Hans-Wis/Magpie_M3V/dv/cdc_rdc/README.md

# dv/cdc_rdc — M3V CDC/RDC/X-prop (ADR-0063 V2, pending)

Single-clock design -> RDC focus (domain_rstn, ADR-0047). See dv/README.md.
