Hans-Wis/Magpie_M3V/design/cpu_m1/rtl/README.md

# cpu_m1 RTL

RTL grows from canonical flow stage 2 (`fetch`). Legal internal and open-source
references may inform implementation, but provenance/license notes and
Magpie_M1-specific verification evidence are required when they shape design.
