Hans-Wis/Magpie_M3V/flow/v2_pipeline/phase_p_lint_current/cpu_m1_phase_p_lint_current/consolidated_reports/cpu_m1_top_lint_lint_rtl/README

################################################################################
#
# This file has been generated by SpyGlass:
#     Consolidated Reports Created by: edauser
#     Consolidated Reports Created on: Tue Jun  9 21:41:33 2026
#     Working Directory              : /home/edauser/project/SOC/Magpie_M1/flow/v2_pipeline/phase_p_lint_current
#     Consolidated Reports Location  : ./cpu_m1_phase_p_lint_current/consolidated_reports/cpu_m1_top_lint_lint_rtl/
#     SpyGlass Version               : SpyGlass_vX-2025.06-SP1
#
################################################################################

This directory contains critical reports generated in current run
In case this directory needs to be compressed using gtar, you may use - 

    % gtar -cvzf <compressed_tar_file_name> ./cpu_m1_phase_p_lint_current/consolidated_reports/cpu_m1_top_lint_lint_rtl/
