Hans-Wis/Magpie_M3V/docs/reports/gemma_opt_ledger.md

# Gemma-3 270M → M3V:架構優化實驗台帳(benchmark-driven)

> **用途**:固定 benchmark = §baseline;每個改善實驗記一列,對比 **vs baseline** + **vs 前一次**,
> 逐次逼近架構最佳執行方式。**鐵律**:每個實驗的 keep/revert 由「**bit-exact 綠 + profiler cycle delta**」
> 兩軌共同裁定——縮 scope / 破 bit-exact / 只在 TB 關功能一律 revert。
> **量測 harness**:`python sim/tools/profile_gemma_layer.py`(Verilator,建 npu_top+cpu_m1,跑 22-step 鏈)。
> **正確性 harness**:`sim/gates/gate_gemma3_layer_rtl.py` + S0–S5 分步 gate(bit-exact vs Tier-C golden)。
> **完整基準分析**:`docs/reports/2026-07-07_gemma270m_m3v_perf_baseline.md`(SSOT)。

---

## Baseline(固定 benchmark)

| 項目 | 值 |
|---|---|
| **一層 wall-clock** | **349,824 cyc**（HEAD @108f2af，profiler 重現 ±0，**已鎖定**）|
| 初始（Cycle-1 前）| 375,672 cyc |
| scalar core | ~89% wall（GEMM 33.3% / nonlinear 66.7%）|
| mat busy | 5,658（MAC 1,104 / requant 4,290）|
| dma busy | 34,955（10.0%）|
| representative dims | seq 4 · hidden 64 · nh 4 · hd 16 · ffn 128 |

**逐-step core\*（重現確認,前 5 大熱點）**:ewise_mul **36,547** · QK-norm_q 29,857 · RoPE_q 25,835 ·
RMSNorm(×4 各 ~23.8-24.1k) · gate/up_proj 各 18,002。**單步之冠 = ewise_mul 36,966 total。**

---

## 實驗紀錄

| # | 實驗 | 改動層 | 攻擊 | vs baseline | vs prev | bit-exact | 判定 |
|---|---|---|---|---:|---:|---|---|
| **E0** | baseline（RVV Cycle-1 residual）| RVV firmware | residual | — | — | ✅ gate 綠 | **BENCHMARK** |
| **E1** | **ADR-0066 MAT_REQUANT_VEC — ewise_mul requant 卸給 mat_engine 64-bit** | RTL(+S_LV)+ SSOT + firmware + runtime | ewise_mul 36,966（單步之冠）| *(E1a RTL done, E1b runtime pending)* | — | E1a ✅ | 🔄 E1a 完成 |
| **PA** | **ADR-0067 v2 Phase A — GEMM 硬體 tile sequencer**（npu_ml_ctrl）| 新 RTL(control shell)+ mux + firmware + gate_67 | GEMM per-tile 編排稅 | **q_proj 13,350→4,282 = 3.12×** | — | ✅ 512/512 byte-exact | ✅ **達標(超 ≥2×)** |
| **B1** | **Phase B B1 — activation-stationary**（activation 載一次@TCM 0xB40)| npu_ml_ctrl S_LOADA + mode bit + runtime blob 重打包 | DMA 冗餘 activation 重載 | **4,282→3,403 = vs 韌體 3.92×** | **−879(dma −893)** | ✅ 512/512 | ✅ **達標** |

**PA 實測分解(gate_67,q_proj 8-tile,我獨立跑)**:ML 硬體路 4,282 = mat **680**(=韌體 680,計算不變)+ dma **3,408**(≈韌體 3,618)+ **編排 194**(韌體 core* 9,052→194,**46× 縮**)。**省的 100% 是 per-tile 韌體編排稅**;mat=680 相同證同一 GEMM(apples-to-apples)。**新瓶頸=DMA(80%)→ Phase B(overlap + activation-stationary)。** RTL review-clean(Grok 無 FSM bug + Codex 3 must-fix 已修:registered readback / !cfg_bypass / err 終止)· ML_V2_EN=0 零回歸(gate_45/46)。commits d360a03/6df51ed/3958919。

**B1 實測(gate_67 B1 test,我獨立跑,@415ac80)**:q_proj 4,282→**3,403**,dma 3,408→**2,515(−893=冗餘 activation,精準命中投影)**,mat 680 不變,other 194→208(多一次 S_LOADA)。**bit-exact 512/512(同 golden)**。設計+Grok/Codex review 一致(B1-first / TCM_ACT=0xB40 / group-scoped / bit-exact 驗證取代 E1 交易等價 / B2 延後)。gate_67 加 dma<3000 守衛防「照載不誤」。scope=n_groups==1(case assert)。Phase A 路仍 4,282 可選;零回歸。**效能軌跡:韌體 13,350 → PA 4,282(3.12×)→ B1 3,403(3.92×)。下一步 B1.1 header-trim(Grok ~2,400=~5.5×,Codex 提醒較大 layout surgery)/ B1.2 multi-group / B2 double-buffer(延)。**

---

## 實驗細節

### E0 — Baseline
- **內容**:HEAD 現況。RVV Cycle-1 已把 residual 19,251×2 → 6,306(3.05×),layer 375,672 → 349,824。
- **證據**:profiler 重現 **349,824(±0)**;S0–S5 gate 全綠。
- **狀態**:固定 benchmark。後續所有實驗對此列比。

### E1 — ADR-0066 MAT_REQUANT_VEC（ewise_mul requant 卸載）
- **假設**:ewise_mul(36,966,全層單步之冠)的 core* 是純量逐元素 srdhm(`__ashrdi3` per-element
  function call)。改成 RVV 算 int32 `a·b` 前段 + mat_engine 現成 64-bit srdhm 後段(新 CMD_LOADVEC +
  CQ opcode 14),預期單步 36,966 → **~10-15k(保守 2-4×)~ 2.5-4k(樂觀)**。
- **為何是 bit-exact by construction**:走的就是 CMD_RESCALE datapath,ewise golden 本來就 mat_engine 同源。
- **改動**:①SSOT yaml(opcode 14 + CMD_LOADVEC)→ regen 3 artifact(gate_35 regen-diff)②mat_engine.v
  加 S_LV(照 review §2 修正:param_bad + t_a_re + padded-64 契約)③firmware handler ④runtime lowering。
- **驗證**:單元 bit-exact(64 相異 int32 vs mat_golden.requant,防退化廣播/transpose)→ gate_gemma3_s0
  byte-identical → profiler 量 ewise_mul 單步 + layer delta。
- **步序(a/b 拆分,增量 de-risk)**:
  - **E1a ✅ 完成且全綠(2026-07-07,Codex 實作 + Claude 獨立驗證)**:SSOT(opcode 14 + CMD_LOADVEC=3'd5)
    + mat_engine.v `S_LV=4'd9`(el_grp 8-window 線性載 acc[0..63]、t_a_re 含 S_LV、param_bad clause、
    review §2 修正全含)+ firmware `CQ_OP_MAT_REQUANT_VEC` handler(含 out_base 還原)+ 單元 TB。
    **驗證(Claude 獨立跑)**:①單元 bit-exact `checks=134`(64 相異 int32 含 I32_MIN/MAX/負 corner,
    逐 byte vs mat_golden.rescale,distinct+>48-varied 斷言防廣播/transpose,param_bad 兩項)②gate_35
    regen-diff 4 passed ③lint 0 新 warning ④**additive-safety 回歸 gate_45/46 = 3 passed(舊 GEMM/RESCALE
    bit-exact 不變,確認純 additive)**。RTL diff 人工複審正確(S_LV 無 transpose/off-by-one)。
    **硬體 requant-offload 路 bit-exact 已證。**
  - **E1b(待 E1a 綠)**:runtime ewise_mul lowering = RVV int32 `a·b` 前段 + MAT_REQUANT_VEC 描述子;
    gate_gemma3_s0 byte-identical → profiler 量 ewise_mul 單步 + layer delta → 填 E1 列(vs baseline/prev)。
- **descriptor packing(定案,比 ADR 草稿精簡:per-tensor 免 TCM param blob)**:W0=op14+ACC(bank)+RPT;
  W1=mult_q31;W2=(rsp<<16)|clamp[rsp=(out_zp<<8)|shift,clamp=(clamp_max<<8)|clamp_min];W3=(src<<16)|dst。
  handler 設 out_base=dst 後還原 0x800(防 state 污染 GEMM RESCALE)。

---

## 決策日誌(為何選這個實驗)

- **2026-07-07 · E0 鎖定 + E1 選定**:baseline profiler 重現 **349,824 ±0**。原 roadmap #1 = GEMM
  de-spin,但 **root-cause 重排了它**:
  - `_chunks` 已最佳(K=64→1 chunk);gate_proj = 16 tiles × 6 CQ-op = 96 op,**core* 18,002 = 每-op
    韌體固定稅 ~187 cyc**(descriptor fetch + csr_write noinline + loop),與引擎/DMA 不重疊。
  - **單純融合 q/k/v 只省 step 級固定稅(~2%)**——op 數是 per-tile,融合不減 op。真正砍 GEMM core* =
    砍每-op 韌體成本 = **高 blast radius 共享韌體**(影響全部 tflm/mobilenet/mlperf/gemma gate)。
  - **結論:GEMM 是「小 ROI + 高風險」,不宜當 E1。** 逐-step 看,**ewise_mul 單步 36,966 = 全層最大單體**,
    ADR-0066 已三方 review=ACCEPT、bit-exact by construction、攻最大熱點 → **ROI/風險雙勝,選為 E1**。
    (GEMM 每-op 韌體瘦身 + activation-stationary 留作後續實驗,待 E1 建立迴圈信心後再碰共享韌體。)

- **2026-07-08 · soc M3a = npu_dma AXI 寬度隨 LANES(DMA 瓶頸 bus-層攻)**:v2 Phase B 後 q_proj 殘餘 ~80%
  = DMA。`DMA_DATA_W∈{32,64,128,256}` hard-bind 64×MAT_LANES,拓寬權重載入路(寬 AXI 讀 + 寬 SRAM 讀 +
  WPB bank-parallel TCM 寫),writeback 保持窄。**ml_v2 q_proj B1.1 全 SKU bit-exact 實測**:

  | SKU | DMA_DATA_W | total cyc | mat | **dma** | other |
  |---|---|---|---|---|---|
  | LANES=4 | 32(regression) | 2425 | 680 | **1539** | 206 |
  | LANES=1 | 64 | 2137 | 1064 | **867** | 206 |
  | LANES=2 | 128 | 1546 | 808 | **531** | 207 |
  | LANES=4 | 256 | 1243 | 680 | **363** | 200 |

  **dma 1539→363(/4.2)** 單調降(純載入 beats /WPB;殘餘=窄 writeback 16 字 + AR floor→M3b 再推)。
  **balanced-design 兌現**:LANES1/64b(2137)快過 LANES4/32b(2425)=DMA 是瓶頸,寬 bus 即使少 MAC 仍勝;
  LANES4/256b(1243)=MAC+bus 齊寬最快。q_proj 軌:韌體 13,350→PA 4,282→B1.1 2,425→**M3a/256b 1,243(10.7×)**。
  零回歸 default-32 位元同。green-wash:SRAM 真一拍供 WPB 字(dma 單調降即證)。ADR-0068 §2.5/M3;
  SSOT `design/npu/docs/npu_dma_m3_width_design.md`。**下一步 M3b writeback 寬化 + CQ 對齊泛化。**

- **2026-07-08 · soc M3b-1 = DMA writeback 寬化(dma floor 再降)**:M3a 讀路寬化的鏡像上寫路(npu_dma STORE
  發寬 AW/W beat + 寫側 ERR_ALIGN + npu_tcm DMA 讀埠 WPB parallel)。ml_v2 q_proj B1.1 @256b:**dma 363→251
  (-112cyc)**、total 1,243→**1,129**;per-tile STORE 16 字×8=128 窄 beats→16 寬 beats,如預測。全 bit-exact
  + 零回歸 12 passed。**q_proj 軌:韌體 13,350→PA 4,282→B1.1 2,425→M3a 1,243→M3b-1 1,129(11.8×)**。
  剩 M3b-2(CQ prefetch 對齊)+ M3b-3(region guard)。SSOT `design/npu/docs/npu_dma_m3b_design.md`。

- **2026-07-08 · soc M3b-2 = narrow two-tier DMA(通用 CQ 路寬 SKU 安全,非 perf)**:寬 DMA SKU 下通用
  cq_sequencer 路(gate_46/gemma)會 ERR_ALIGN-trap(descriptor prefetch ring 幾何無法對齊)。Option C:
  npu_ml_ctrl 快路維持寬(dma=251 不變)+ CSR/通用路 hard-tie 窄(不 trap,cq_sequencer 零改)。gate_46
  @256 bit-exact 零 trap。兩層共存一 npu_dma。誠實 two-tier(不宣稱 full 256b everywhere)。

- **2026-07-08 · soc M3c = npu_dma 寬度 PPA(DC TSMC28,寬 DMA 相對計算近乎免費)**:真 Synopsys DC 綜合
  npu_dma(std-cell)掃 DMA_DATA_W 32/64/128/256 @1.2ns:面積 689→809→919→1143µm²(+66%,8×寬只
  1.66×面積 sub-linear,增長全 combinational 資料路,flops 持平)。npu_dma@256=1143µm² vs mat_engine
  256-MAC=83,868µm² → 寬 DMA 資料路 ~1.4% 引擎面積 → **付 +453µm² 換 dma cycle ~6×(1539→251)= 明確
  PPA win**;balanced-design SKU 成立。caveat:SRAM/TCM macro 埠寬另計。報告 2026-07-08_dma_width_ppa.md。
  **soc M3 全弧完成(M1→M2→M3a→M3b→M3c)= 兩-AXI 架構 + PPA 驗證;q_proj 13,350→1,129(11.8×)。**

- **2026-07-08 · RMSNorm→RVV(最大單筆非線性軟體省,零 RTL)**:向量化 scalar MAT_RMSNORM 每元素 64-bit
  SRDHM scale loop → in-core Zve32x(sum_sq=vwmul+vredsum 精確;scale=vwmul→vsmul.vx(M)→vssra.vx(S)→
  vmax/vmin→vncvt→i8,vxrm=rnu csrw)。**rounding 重定義(Gemma-private)+ 獨立 Spike-validated golden**
  (rvv_bitmodel.py 純 spec;gate_rvv_bitmodel_spike vs Spike → 非湊 RTL)。**cycle RMSNorm ~24k→~13k/op
  (-11k×4≈-44k/層);全層 349,824→307,458**。**flip 0/256 max delta 0**(RVV rounding 對 real tensor 輸出
  完全相同=重定義實質 no-op)。gate_gemma3_s1(hidden=64)+ layer 全鏈 bit-exact(我獨立 5 passed);disasm
  無 __muldi3/__divdi3/__ashrdi3。誠實:hidden=64 驗;H=640 全模型 descriptor 加寬 follow-up。
