Hans-Wis/Magpie_M3V/design/npu/docs/strip_rail_promotion_design.md

# Strip 模式推廣到真 rail(設計確認,§2;ADR-0073 addendum)

Status: ACCEPTED-to-implement(User 裁示 2026-07-10「strip 模式推廣到 gemma/tflm
真 rail」;契約承 ADR-0073,本檔僅收斂推廣面)
原則:**同輸出、換運輸** —— 全部既有 golden(gate_46/gemma/tflm)一個位元組都
不改;GEMM 步的執行從「逐-tile 通用 CQ op 鏈」換成「單一 strip job」。

## 1. CQ SSOT 新 op(gate_35 regen-diff 守衛)

`MAT_STRIP_GEMM`(value **15**):
- `W1` = W_BASE(shared/DDR byte 位址,4KB 對齊 —— sanitizer 檢)
- `W2` = `(N_STRIPS[11:0]<<17) | STRIP_BYTES[16:0]`
- `W3` = `(K_CHUNKS[7:0]<<24) | (K_TAIL[6:0]<<17) | (N_TAIL[6:0]<<10) | out_dst64[9:0]`
  (out 目的 = shared byte 位址 / 64;block 本就 64B 對齊)
- 語意:sequencer 驗參(沿 ADR-0073 illegal 表 + 4KB 對齊 + out 界內)→ 寫
  ml_ctrl CSR(0x94..0xA8 + 新 **ML_OUT_BASE 0xAC**)→ GO → poll ML_STATUS.DONE;
  ml 錯(含 ML_STRIP_DMA_ERR=9)→ `cq_halt(CQ_ERR_MAT_PARAM 家族新碼 STRIP_ERR)`。
- **shared strip job blob 契約(凍結,2026-07-10 addendum)**:`W_BASE` 起連續:
  `[weights: N_STRIPS*STRIP_BYTES] ++ [param blocks: ceil((N_STRIPS*64)/8)*64B]
  ++ [activation chunks: K_CHUNKS*512B]`。activation chunk 維持每 chunk `[k][8]`
  packing(8 rows × 64 k,尾段由 emitter 補零)。`N_TAIL` 只裁最後 strip 的 compute;
  params 的 N 由 `N_STRIPS*64` 推得,tail param blocks 仍存在且由 emitter zero-pad。
- **sequencer staging 契約**:`MAT_STRIP_GEMM` handler 自行用 wrap-safe bounds 驗
  shared blob/TCM 目的範圍,再把 params copy 到 `0x1200+i*64`,activation chunks copy 到
  `OP_A_ADDR+c×0x200`,之後才寫 ml_ctrl CSR 並 GO。generic `MAT_LOAD_W` 的 dst bound
  guard 不放寬,也不再用它搬 strip params/activation。

## 2. RTL delta(唯一一處,ml_ctrl)

`ML_OUT_BASE`(0xAC,RW):strip 模式 STORE 目的基址(sub-tile 塊 @base+
(s×8+t)×64)。reset = 舊 DST_BASE 值(**legacy/gate_97 零回歸**)。其餘 RTL 零改。

## 3. Host lowering(軟體)

- 共用 helper `strip_blob.py`(design/npu/sw/gemma 或 tools):任意 [N,K] int8
  權重 → ADR-0073/D4 凍結佈局 blob(offset(c,t)=c×4096+t×512,[k][8])+ 64B
  參數塊序列;gemma 與 tflm lowering 共用。
- 首批遷移 rail:①gate_46 的 q_proj-class CQ 矩陣 rail(K=64,N=64=1 strip
  ×8 sub-tile);②gemma FFN gate/up(toy N=128 = **2 strips,真 multi-strip +
  prefetch/rendezvous 上真 rail**)。其餘 gemma/tflm GEMM 步同 helper 逐步換,
  不在本輪強制。

## 4. 驗證

1. `gate_35` SSOT regen byte-identical(schema 改必跑)。
2. `gate_46` 新增 strip 變體測項:同一輸入走 MAT_STRIP_GEMM,**輸出位元組 ==
   既有 golden**(golden 檔零改動);原逐-tile 測項保留(通用路零回歸)。
3. gemma gate/up strip rail 測項:bit-exact vs 既有 layer golden 對應段。
4. 零回歸批:gate_36/37/38(CQ 行為)、gate_97/98(合成 strip)、e2e 常備批。
5. 誠實界:本輪 shared-SRAM 為 DDR 替身(真 DDR 掛接 = Magpie_DDR 線);未遷
   移的 GEMM 步仍走通用路(two-tier 誠實延續)。

## 5. Audit addendum(2026-07-10)

`tb_npu_cq_mat` 的早期 `STRIP_VARIANT` 直接用 TB/AXI pokes 把 strip params 放到
`0x1200`,activation 放到 `OP_A_ADDR`,因此沒有覆蓋 production sequencer staging path。
本 addendum 後該變體的 shared blob builder 改成追加 params+activation,只透過
`MAT_STRIP_GEMM` handler staging,避免遮蔽 generic `MAT_LOAD_W` 對 `0x1200` 的合法
bound guard。

## 6. 全 FC 擴充(2026-07-10 addendum,User 裁示「其餘 GEMM 步換 strip」)

tflm FC 需 fold/bias + input_zp(入 fold)+ zp_out/clamp(ReLU)。**blob v2 凍結**:
`W_BASE` 起 = `[header 64B] ++ [weights] ++ [param blocks ceil(N/8)*64B] ++
[fold blocks ceil(N/8)*32B(8×int32/sub-tile)] ++ [act chunks K_CHUNKS*512B]`。
header = {magic 'STR2', rsp(如 RESCALE 之 (out_zp<<8)|shift 慣例中之 zp 部分)、
clamp、版本、保留};handler 讀 header → 寫新 CSR **ML_RSPCLAMP(0xB0)**;
ml_ctrl strip FSM:LOADACC fold ptr = **STRIP_FOLD_PTR(0x1600)+ 全域 sub-tile
×32**(鏡射 param ptr 索引;GeGLU 情形 emitter 寫零 fold,行為不變);RESCALE_PC
的 rs_zp/clamp 自 ML_RSPCLAMP。emit_layer_strip 支援全 fc dict(fold 計算與
emit_layer_v2 同式);GeGLU 限定解除。gate 面:s2 q/k/v/o、s0 down(**K=128 =
真雙 K-chunk 上 rail**)、tflm gate_48/49/50 雙運輸測項(golden 不可變)。
