Hans-Wis/Magpie_M3V/docs/reports/rtl_consistency/report.md

# Magpie_M1 RTL Consistency Report

**Date:** June 8, 2026  
**Auditor:** Gemini CLI  
**Scope:** `design/cpu_m1/rtl/`  

## 1. Executive Summary
The RTL is highly consistent and follows a well-defined architectural pattern (4-stage pipeline with variable-latency memory support). The use of `def.vh` ensures constant consistency across opcode and control encodings. The primary findings relate to potential metastability in the external IRQ path and slight deviations in the Register File reset strategy.

## 2. Findings Table

| ID | File:Area | Issue | Severity | Verify |
| :--- | :--- | :--- | :--- | :--- |
| **01** | `rfu.v` | **Inconsistent Reset:** Uses `initial` block for register initialization and lacks hardware `resetn` in the write path. | Low | Check if ASIC synthesis is intended; FPGA handles `initial` fine. |
| **02** | `csr.v` / `core.v` | **IRQ Synchronization:** `irq_external_pulse` is used directly in CSR logic. Comment says "debounced" but no synchronizer is visible. | Med | Confirm top-level `system_pynq.v` provides a synchronized pulse. |
| **03** | `cpu_m1_top.v` | **Data Path X-Prop:** `i_rdata_q` and `d_rdata_q` are not reset. Typical for data paths but can cause simulation noise. | Low | Review simulation logs for early X-propagation on I/D rdata. |
| **04** | `csr.v` / `core.v` | **CSR Forwarding Timing:** Nested combinational forwarding (`new_val` -> `csr_rdata` -> `id_csr_rdata`) may create a long timing path. | Med | Check timing closure at >75MHz for CSR instruction paths. |
| **05** | `core.v` | **Unconnected LSU Ports:** `lsu` instances have intentionally unconnected ports (e.g., `ld_result` in ID stage). | Low | Valid usage, but verify Linter doesn't flag as error in strict modes. |
| **06** | `div.v` | **State Machine Reset:** `state` is reset to `IDLE`, but `quotient`/`remainder` are only cleared on `start`. | Low | Safe, but `IDLE` could leak stale values to `result` mux. |
| **07** | `bp.v` | **LRU Reset:** LRU bits are reset to 0, biasingWay 0 as the first replacement target. | Low | No functional issue, purely an observation on cold-start behavior. |

## 3. Detailed Review

### 3.1 Reset Convention Consistency
- **Standard:** All modules (except RFU) use **active-low synchronous reset** (`resetn`) triggered by `posedge clk`.
- **Deviation:** `rfu.v` relies on an `initial` block for simulation/FPGA power-on state. This is a mismatch with the core's general policy of explicit hardware resets for all architectural registers.

### 3.2 Signal Naming Consistency
- **High Consistency:** `stall`, `flush`, `valid`, and `redirect` are used with identical semantics across `core.v`, `ifu.v`, and `hazard.v`.
- **Memory Freeze:** `mem_stall` is correctly propagated from the `cpu_m1_top` wrapper to the core, implementing the **ADR-0005** freeze policy consistently across all pipeline stages.

### 3.3 X-Propagation Sources
- **Risk Mitigation:** Most `always @*` blocks (ALU, IDU, LSU, CSR) include `default` assignments or exhaustive `case` coverage to prevent latches and X-prop.
- **Observability:** `trap` is latched in `core.v` to ensure synchronous exceptions are stable for the wrapper to observe even if the internal signal pulse is narrow.

### 3.4 Clock & CDC
- **Single Domain:** The design is strictly single-clock (`clk`).
- **External Signals:** `irq_external_pulse` is the only cross-domain candidate. The implementation assumes it is already a synchronous pulse. If this comes from a button or external pin, a 2-flip-flop synchronizer is required.

### 3.5 Pipeline Register Conventions
- **Freeze Policy:** `EX/MEM` and `EX/WB` stages correctly implement the `mem_stall` hold condition.
- **Forwarding:** `forward.v` correctly prioritizes `EX/MEM` (closest) over `EX/WB` (further). It correctly prevents forwarding from `EX/MEM` for `is_load` instructions since the data is not yet available in that cycle.

---
*Report generated by Gemini CLI RTL Consistency Auditor.*
