Hans-Wis/Magpie_M3V/flow/fpga/pynq_z2/clockInfo.txt

-------------------------------------
| Tool Version : Vivado v.2024.2
| Date         : Wed Jun 10 12:16:07 2026
| Host         : eda
| Design       : design_1
| Device       : xc7z020-clg400-1--
-------------------------------------

For more information on clockInfo.txt clock routing debug file see https://support.xilinx.com/s/article/000035660?language=en_US
