Hans-Wis/Magpie_M3V/flow/v2_pipeline/phase_05_01_synth_ppa/ppa_summary.txt

status=trial_pass
trial_estimate=true
top=cpu_m1_top
target_period_ns=1.43
target_frequency_mhz=699.30
area_um2=26298.467795
wns_ns=0.00
tns_ns=0.00
setup_violating_paths=0
hold_wns_ns=-0.01
hold_violating_paths=2
total_power_mw=15.8503
dynamic_power_mw=15.8315
leakage_power_uw=18.2730
library=tcbn28hpcplusbwp40p140tt0p9v25c
library_path=/home/edauser/project/SOC/Magpie_X3/APR/ref/db/tcbn28hpcplusbwp40p140tt0p9v25c.db
corner=tt0p9v25c
notes=DC compile_ultra trial only; no scan/DFT; no SAIF/VCD switching activity; segmented zero-wireload estimate; report_constraint shows two min-delay/hold violators.
