Hans-Wis/Magpie_M3V/flow/v2_pipeline/phase_05_leader/PROGRESS.md

# Magpie_M1 CPU IP Progress Report
**Date:** 2026-06-08
**Status:** In Progress (Stage 5.0 PPA Trial)

## 1. Where We Are
We have successfully achieved **Stage 5.0 RTL Lint Signoff** using Spyglass with zero errors/fatals. The project has also reached a major milestone in **functional verification** with a baseline functional coverage measured at 55.56% and 172 regression gates passing. Licensed EDA tools (VCS/URG/Spyglass) are now fully operational following the resolution of sandbox network isolation issues.

## 2. Flow Stage Status
| # | Stage | Status | Metrics / Notes |
|---|---|---|---|
| 0 | isa_scope | PASS | RV32IMC_Zicsr_Zifencei (ADR-0002) |
| 1.x| pipeline_structural | PASS | Fetch/Dec/Exec/Hazard/BP/RAS integrated |
| 2.x| trap_mem_wrapper | PASS | Valid/Ready wrapper + Trap/IRQ logic |
| 3.0| spike_lockstep | PASS | 81 commits clean vs Spike (bare_core) |
| 3.8| lockstep_revalidate| PASS | Integrity confirmed (gate_03_08) |
| 4.0| coverage | **PARTIAL** | 55.56% (40/72 bins). Branch/CSR groups @ 0% |
| 5.0| lint_rtl | PASS | 0 Error / 0 Fatal / 24 Warn (Spyglass) |
| 5.1| synth_ppa (J4) | **RUNNING** | DC synthesis trial (TSMC 28HPC+) |

## 3. Recently Completed
- **Stage 5.0 LINT:** Spyglass `lint_rtl` signoff completed (ADR-0006). 0 fatal, 0 errors, 24 warnings (advisory). STARC policy: 0 errors.
- **Verification Integrity:** 172 gates pass. Re-validated lockstep (gate_03_08) confirms no regressions during recent refactors.
- **License Infrastructure:** Fixed licensed tool access by switching to `-s danger-full-access` in Codex (bypassing sandbox network isolation).
- **Coverage Measurement:** First real VCS-COV + URG run completed (J2b).

## 4. In Progress (J4)
- **DC Synthesis Trial:** Running `gate_05_01_synth_ppa` for TSMC 28HPC+ target.
- **Initial PPA Extraction:** Measuring area, frequency, and leakage for the current pipeline configuration.

## 5. Honest Gaps & Risks
- **Coverage Hole (55.56%):** While the threshold is met, the distribution is skewed. ALU/M (81.0%) and Load/Store (91.7%) are healthy, but **Branch/BP/RAS and CSR/Trap groups are at 0.00%** due to random-only stimulus.
- **Stimulus Gap:** Directed trap and branch recovery tests have not yet been merged into the unified coverage run.
- **Volume Risk:** Lockstep equivalence is currently limited to 81 commits. Higher volume (1M+ instructions) random testing is required for signoff.
- **Taxonomy:** **IP NOT QUALIFIED.** Status remains `IN_PROGRESS` due to coverage gaps and pending PPA results.

---
*Generated by Gemini CLI - 2026-06-08*
