Hans-Wis/Magpie_M3V/dv/lint/README.md

# dv/lint — M3V Spyglass lint (ADR-0063 V2, pending)

Extends the ADR-0006 lint contract to the NPU/RVV/mat_engine modules. See dv/README.md.
