Hans-Wis/Magpie_M3V/flow/v2_pipeline/phase_01_99_phase1_closure/README.md

# Phase 1.99 Phase 1 Closure

Status: phase1-structural-closure-pass target.

This phase closes Phase 1 as a productization bring-up milestone:

- Phase 1.0: lab08e active RTL baseline/provenance/lint
- Phase 1.1: fetch/RV32C/pre-fetch smoke simulation and review VCD policy
- Phase 1.2: decode/execute RV32IMC structural/lint contract
- Phase 1.3: pipeline hazard structural/lint contract
- Phase 1.4: BP/RAS/redirect structural/lint contract

Phase 1 closure does not qualify the CPU IP. It only proves the active lab08e
RTL baseline is integrated, lint-parsable, smoke-runnable, structurally mapped
to the Phase 1 microarchitecture features, and ready for Phase 2/3 functional
qualification work.

Residual work transferred out of Phase 1:

- Directed RV32I/M/C tests -> Phase 2 directed qualification and Phase 3 Spike
- CSR/trap/IRQ -> Phase 2.0
- Valid-ready memory wrapper -> Phase 2.1
- Spike lockstep and Google RISC-V DV -> Phase 3.0
- Coverage closure -> Phase 4.0
- Lint/synth/PPA sign-off -> Phase 5.0

Current evidence:

- `tests/gates/gate_01_99_phase1_closure.py`
- `docs/phase1_closure_report.md`
- `docs/v2_pipeline_full_verification_report.md`
- `flow/state/magpie_m1.isa_scope.state.json`
