Hans-Wis/Magpie_M3V/docs/reports/2026-07-09_fdiv_multicycle_poc.md

# fdiv + fsqrt + vdiv multi-cycle — Fmax 166.7 → ~390 MHz (PROVEN)

- **Date:** 2026-07-09 · **Author:** Claude · **Commits:** `ed61f50` (fdiv), `648948e` (fsqrt), `8e01b25` (vdiv) · **Scope:** PoC → full three-wall removal per User (「先做 fdiv 單點 PoC 實證 Fmax 上升」→「續做 fsqrt」→「續做 vexu vdiv 迭代化」)

## ★ RESULT — Fmax 166.7 → ~460 MHz (2.8×), area −50%, wall left the CPU core

| stage | Fmax | crit path | worst wall | area |
|---|---|---|---|---|
| signoff (all-combinational dividers, 6.0ns) | 166.7 MHz | 5.93 ns | fexu fdiv / vexu vdiv | 820,600 µm² |
| **+ fdiv+fsqrt+vdiv iterative** (2.5ns) | **~390 MHz** | 2.53 ns | fexu **FMA** + scalar mul | 443,815 µm² |
| **+ FMA 2-stage** (2.2ns) | **~460–470 MHz** | **2.13 ns** | **mat_engine 256-MAC acc** | **413,858 µm²** |

**Total: Fmax 166.7 → ~460 MHz (2.8×), area 820k → 414k µm² (−50%).** After the FMA
2-stage the critical path **left the CPU sequencer core entirely** and now sits on
the **mat_engine 256-MAC accumulator** (`u_mat/acc_reg`) — a separate compute-engine
domain. fexu (fdiv/fsqrt/fmul/**fma**), vexu (vdiv/RVV), and scalar mul/div are all
below 2.13 ns. Dynamic power 276.9 mW @470MHz / 192.9 mW @390MHz / 15.96 mW @167MHz
(scales with clock; unannotated). `ppa_summary_accel.txt` (390) + `ppa_summary_fma2s.txt` (470).
- **Goal:** prove the multi-cycle-divider mechanism (a) integrates bit-exactly and (b) removes the fdiv combinational cone from the EX critical path — the first step toward raising npu_top Fmax (166.7 MHz, gated by fexu float + vexu vdiv).

---

## 1. What was done

Replaced the combinational fdiv significand divide in `fexu.v` — `num = num / {40'b0, sgB}` (a full-width restoring-division array, one of the deepest EX cones) — with an **iterative radix-2 restoring divider** (56 steps, one 25-bit compare+subtract per cycle). Special cases (NaN/inf/zero/DZ) still resolve in one combinational cycle.

- **Bit-exact by construction:** integer division has a unique answer, so an iterative restoring divide of the same numerator/divisor yields the identical `floor(num/sgB)`. The softfloat sticky `(sgB*q != num)` reduces exactly to `rem != 0` (since `num = q*sgB + rem`), so the round-pack input is identical.
- **Handshake mirrors the proven `div.v`** (scalar M-ext divider): `q_fdiv_busy` stalls the pipe (into `vex_stall`) while iterating; result held until `q_advance`; `q_flush` kills a wrong-path fdiv on redirect/debug (ERRATA-0002). Host `EN_F=0` ties busy to 0 — non-fdiv ops and the host core are untouched (additive stall term only).

## 2. Verification — bit-exact, zero regression (authoritative)

| Check | Result |
|---|---|
| `gate_61` F2-F4 (incl **fdiv.s/fsqrt.s** directed corners) | f2 **301 commits** + frand random **1085 commits/seed ×3** = 4 passed |
| `gate_60` F1 | 3 passed |
| `gate_77` vdiv (vector) | 3 passed |
| `phase_20` NPU core directed (rv32im) | **1164 commits** bit-exact |

Latency changes, architectural values identical → Spike commit-lockstep unchanged. **The multi-cycle mechanism is proven correct.**

## 3. Timing finding — fdiv cone removed, but Fmax NOT moved by fdiv alone

**Structural (RTL):** the combinational divide array is gone — `grep` confirms `num / {…}` no longer exists in `fexu.v`; the only per-cycle arithmetic is a 25-bit `fd_rem_sh - fd_dsor` radix-2 step (shallow).

**But the fexu result register is a shared wall.** Standalone DC of `fexu` (EN_F=1) shows the critical path endpoint stays at **`q_fdata`** — the FP-result mux that feeds `ex_mem_f_data_r` (the npu_top #1 endpoint). That mux is *also* driven by:
- **fsqrt** — an **unrolled 31-iteration** restoring integer sqrt (`fexu.v` `f_sqrt`), and
- **fma** — a 64-bit product + align + add,

both combinational and comparable in depth to the old fdiv. So removing **only** fdiv shifts the wall to fsqrt/fma; the `ex_mem_f_data_r` path length (npu_top: 5.93 ns → 166.7 MHz) is essentially unchanged.

> **Honest scope note:** this is inferred from (a) the RTL structural removal and (b) the standalone-fexu endpoint staying on `q_fdata` via the remaining combinational ops. A full npu_top before/after DC (≈3 h) was **not** re-run for a number that structural analysis already predicts as flat — running it to confirm "still ~167 MHz" is low value.

## 4. fsqrt also made iterative (`648948e`) — fexu-arith wall now fully removed

Rolled the unrolled 31-iteration restoring integer sqrt into the same iterative FSM (31 cycles, 2 radicand bits/step, bit-exact). Float multi-cycle busy unified: `q_fmc_busy = fdiv_busy || fsqrt_busy`. Same bit-exact zero-regression verification (gate_61 incl fsqrt.s corners 301+1097, gate_60, gate_77, phase_20 1164).

**Structural proof the fexu-arith divide/sqrt cones are gone:** a fresh npu_top DC (CLK 3.0 ns) allocates **only `DW01_add`** DesignWare inside `fexu_EN_F1` (from fma/fadd) — **no `DW_div`/`DW_sqrt`**. Every remaining `DW_div_*` (width 8/16/32) belongs to **vexu vdiv**.

## 5. Fmax finding — the binding wall is now vexu vdiv, NOT fexu

The DC signoff worst-path list (`600db43` timing report) shows **two** co-equal 5.93 ns walls at slack 0.00 @ 6.0 ns:
- `ex_mem_f_data_r` (fexu float) — **removed by this PoC**, and
- `ex_mem_vex_wdata_r` (vexu vdiv, path `u_vexu/q_instr[22] → … → ex_mem_vex_wdata_r`) — **untouched**.

The fresh DC confirms it directly: with fdiv+fsqrt iterative, the critical-path endpoint **moves to `u_npu_core/u_core/u_vexu`** (the vdiv cone). vexu vdiv is a **32-bit combinational restoring divide** (`g_div32`, deeper than fexu's 24-bit mantissa divide), so it floors at ~the same 5.9 ns.

**⇒ npu_top Fmax stays ~166.7 MHz — now gated *solely* by vexu vdiv.** The fexu-arith tier is off the critical path, but Fmax cannot rise until vdiv is also multi-cycled. (The confirming compile was stopped once the endpoint was proven to be vexu — no value in ~1–2 h more to reconfirm ~167 MHz.)

## 6. Conclusion + recommendation

- ✅ **Mechanism proven across two ops (fdiv, fsqrt), each bit-exact** — the iterative-divider-with-stall pattern scales cleanly. Fully de-risked.
- ✅ **fexu-arith divide/sqrt wall removed** (structurally confirmed: no DW_div/sqrt left in fexu).
- ⚠️ **Fmax not yet raised** — vexu **vdiv** is a co-equal 5.93 ns wall (32-bit combinational), now the sole binding constraint.
## 7. vexu vdiv made iterative (`8e01b25`) — the last wall removed

Per-lane radix-2 restoring divider (SEW cycles/beat), lane-parallel; signed via
unsigned-magnitude + modular-negate fixup; `bz`/`sov` overrides stay
combinational (bit-exact). vdiv routes through `VM_GRP` even at LMUL=1 (unified
hold); `grp_stage` capture + `grp_p` advance gated on `div_done`; the `div_it`
counter free-runs under `div_busy` **independent of `m_stall`** (Grok's deadlock
guard); `m_flush` clears div state.

**Co-work (§2/§5):** design confirmation (`design/npu/docs/vdiv_multicycle_design.md`)
→ Grok architecture review (`docs/reviews/2026-07-09_vdiv_multicycle_grok.md`,
hard requirements) → **Codex** surgical impl (190+/−33 lines) → **Claude**
authoritative verify.

**Verify (bit-exact zero regression vs Spike rv32imf_zve32x):** gate_77 vdiv
directed (3), vrand random ×3 (1324 commits each), full RVV+F suite gate_56..81
+ 60/61 (**90 passed**), phase_20 NPU (directed 1164 + random 10809). Latency
changed, values identical.

## 8. Conclusion

- ✅ **All three combinational divide/sqrt cones removed** (fdiv, fsqrt, vdiv),
  each bit-exact, each zero-regression. The iterative-divider-with-stall pattern
  scaled cleanly from a self-contained fexu op to the intricate vexu multi-beat.
- ✅ **Fmax 166.7 → ~390 MHz (2.3×)**, **logic area −72%**, new wall = fexu fma
  + scalar mul/div (distributed ~2.53 ns). Proof delivered.
## 9. fexu FMA 2-stage (`03570dc`) — wall leaves the CPU core

The fused multiply-add (mult → align-add → round) was the #1 EX path after the
dividers (all top-12 worst paths, 2.53 ns). Split it: **stage 1 registers the
24×24 mantissa product** (`fma_sigProd_r`/`fma_expProd_r`); **stage 2** (the
`f_fma` block) does align/add/normalize/round from the register. Normal FMA takes
1 extra cycle via the existing `q_fmc_busy` stall; specials stay 1-cycle. Because
the op is held in EX, operands stay valid — **only the product needs registering**
(bit-exact). fmul/fadd (<2.5 ns) untouched.

**Verify:** gate_61 (incl fmadd/fnmsub corners) f2 301 + frand 1097 = 4 passed;
gate_60 3; phase_20 NPU 1164; RVV LMUL/vdiv + mat 10 passed — all bit-exact.

**DC (CLK 2.2ns):** timing MET, 0 violating, critical path **2.13 ns → ~460–470 MHz**.
Endpoint moved to **`u_mat/acc_reg`** — the mat_engine 256-MAC accumulator. The
whole CPU sequencer core is now off the critical path.

## 10. Conclusion

Four multi-cycle/pipeline changes (fdiv, fsqrt, vdiv, FMA), each bit-exact and
zero-regression, took npu_top from **166.7 → ~460 MHz (2.8×)** while **cutting
area 50%**. The Fmax wall walked out of the CPU core (dividers → FMA → gone) and
now rests on the **mat_engine 256-MAC accumulate** — the actual compute engine.
Further headroom would require pipelining the MAC accumulator itself (a separate
compute-engine optimization, ~470 MHz is already strong for a 256-MAC).

**Artifacts:** RTL `ed61f50`/`648948e`/`8e01b25`/`03570dc`; DC summaries
`reports/dc_npu_top/ppa_summary_accel.txt` (390) + `ppa_summary_fma2s.txt` (470);
`flow/dc_tsmc28/synth_fexu.tcl`. Production sign-off → full ADR + VCS/coverage per §2.
