Hans-Wis/Magpie_M3V/docs/reports/coverage_report.md

# Magpie_M1 — Coverage Report (Tier-2 §05 deliverable)

Rev 1.0 · 2026-06-11 · Owner: PL (Claude) · design_id = `cpu_m1`
Scope: RV32IMC core (SKU-1, `FEATURE_FREEZE.md`). Authority for correctness = Spike lockstep + gates.
This report is the §05 "Coverage Report (per sub-block + exclusion list)" deliverable, and it contains
the **whole-core toggle gap root-cause analysis** (Tier-2 blocker #1).

## 1. Headline (honest dual-number)

| Metric | Tier-2 bar | Per-island (gate_p02..p14) | **Whole-core (signed number)** | status |
|---|---|---|---|---|
| Line | 100% | 100% | **~95.95%** (1374/1432) | 🟡 |
| Branch | 100% | 100% | **~96%** (gate_p19) | 🟡 |
| Expr/Cond | 95–100% | ≥95% | **~79%** (gate_p19, floor 78) | ❌ |
| Toggle | 95% | ≥95% | **62.93%** (12745/20252, best single run) | ❌ |
| FSM | 100% | 100% | 100% | ✅ |

Per-island modules (alu/lsu/rfu/forward/hazard/mul/div/idu/cdec/csr/ras/bp/ifu) are at Tier-2.
The **whole-core** numbers are the acceptance numbers and are below bar — this report explains why and
how to close.
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
