Hans-Wis/Magpie_M3V/flow/fpga/pynq_z2/tight_setup_hold_pins.txt

+====================+===================+=================================================+
| Launch Setup Clock | Launch Hold Clock | Pin                                             |
+====================+===================+=================================================+
| sys_clk_pin        | sys_clk_pin       | u_cpu/u_axil/i_araddr_reg[31]/D                 |
| sys_clk_pin        | sys_clk_pin       | u_cpu/u_axil/i_araddr_reg[3]/D                  |
| sys_clk_pin        | sys_clk_pin       | u_cpu/u_axil/i_araddr_reg[8]/D                  |
| sys_clk_pin        | sys_clk_pin       | u_cpu/u_axil/i_araddr_reg[2]/D                  |
| sys_clk_pin        | sys_clk_pin       | u_cpu/u_axil/i_araddr_reg[5]/D                  |
| sys_clk_pin        | sys_clk_pin       | u_cpu/u_axil/i_araddr_reg[9]/D                  |
| sys_clk_pin        | sys_clk_pin       | u_cpu/u_cpu/u_core/u_ifu/pc_reg_reg[1]_rep__2/D |
| sys_clk_pin        | sys_clk_pin       | u_cpu/u_axil/i_araddr_reg[12]/D                 |
| sys_clk_pin        | sys_clk_pin       | u_cpu/u_axil/i_araddr_reg[11]/D                 |
| sys_clk_pin        | sys_clk_pin       | u_cpu/u_axil/i_araddr_reg[30]/D                 |
| sys_clk_pin        | sys_clk_pin       | u_cpu/u_axil/i_araddr_reg[7]/D                  |
| sys_clk_pin        | sys_clk_pin       | u_cpu/u_axil/i_araddr_reg[6]/D                  |
| sys_clk_pin        | sys_clk_pin       | u_cpu/u_cpu/u_core/u_ifu/pc_reg_reg[31]/D       |
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
| sys_clk_pin        | sys_clk_pin       | u_cpu/u_cpu/u_core/u_bp/lru_reg[22]/D           |
| sys_clk_pin        | sys_clk_pin       | u_cpu/u_cpu/u_core/ex_mem_csr_rdata_r_reg[30]/D |
+--------------------+-------------------+-------------------------------------------------+
