Hans-Wis/Magpie_M3V/flow/v2_pipeline/phase_p_lint_current/cpu_m1_phase_p_lint_current/cpu_m1_top/lint/lint_rtl/spyglass_spysch/analyzer/1781012492_macro_usage.txt

begin 0
end
begin 1
    begin 2
        2 15 1 ""
    end
end
begin 3
    begin 4
        4 15 1 ""
    end
    3 55 37 "4'd0"
    3 56 38 "4'd1"
    3 57 39 "4'd2"
    3 58 40 "4'd3"
    3 59 41 "4'd4"
    3 60 42 "4'd5"
    3 61 43 "4'd6"
    3 62 44 "4'd7"
    3 63 45 "4'd8"
    3 64 46 "4'd9"
    3 65 47 "4'd10"
    3 66 48 "4'd11"
end
begin 5
    begin 6
        6 15 1 ""
    end
    5 97 2 "7'b0110111"
    5 98 3 "7'b0010111"
    5 99 9 "7'b0010011"
    5 100 10 "7'b0110011"
    5 101 11 "7'b1110011"
    5 102 12 "7'b0001111"
    5 104 4 "7'b1101111"
    5 105 5 "7'b1100111"
    5 106 6 "7'b1100011"
    5 107 7 "7'b0000011"
    5 108 8 "7'b0100011"
    5 117 85 "32'h3020_0073"
    5 131 86 "7'b0000001"
    5 161 37 "4'd0"
    5 165 27 "3'b000"
    5 165 37 "4'd0"
    5 166 29 "3'b010"
    5 166 45 "4'd8"
    5 167 30 "3'b011"
    5 167 46 "4'd9"
    5 168 31 "3'b100"
    5 168 41 "4'd4"
    5 169 33 "3'b110"
    5 169 40 "4'd3"
    5 170 34 "3'b111"
    5 170 39 "4'd2"
    5 171 28 "3'b001"
    5 171 42 "4'd5"
    5 172 32 "3'b101"
    5 172 44 "4'd7"
    5 172 43 "4'd6"
    5 173 37 "4'd0"
    5 177 27 "3'b000"
    5 177 38 "4'd1"
    5 177 37 "4'd0"
    5 178 29 "3'b010"
    5 178 45 "4'd8"
    5 179 30 "3'b011"
    5 179 46 "4'd9"
    5 180 31 "3'b100"
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
end
begin 7
    begin 8
        8 15 1 ""
    end
    7 25 57 "32'h0000_0000"
end
begin 9
    begin 10
        10 15 1 ""
    end
    9 58 24 "3'b000"
    9 62 25 "3'b001"
    9 66 26 "3'b010"
    9 101 19 "3'b000"
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
    27 992 97 "3'b010"
    27 993 98 "3'b011"
    27 994 99 "3'b100"
    27 995 100 "3'b101"
    27 1004 78 "32'h0000_000B"
    27 1005 75 "32'h0000_0003"
    27 1006 74 "32'h0000_0002"
    27 1008 77 "32'h0000_0006"
    27 1009 76 "32'h0000_0004"
    27 1010 73 "32'h8000_000B"
end
begin 29
end
