Hans-Wis/Magpie_M3V/flow/v2_pipeline/phase_05_leader/J1_result.md

## summary
misalign test result: PASS on cpu_m1_top Verilator plus Spike trap-on-misaligned checks.
revalidate-lockstep result: PASS after clean rebuild/rerun of phase_03_05 against current core.v.
## files_added
flow/v2_pipeline/phase_02_02_misalign/firmware.S : directed aligned lb/sb plus misaligned lw/lh/sh program.
flow/v2_pipeline/phase_02_02_misalign/tb_misalign_trap.v : cpu_m1_top Verilator TB with no-misaligned-DBUS assertion.
flow/v2_pipeline/phase_02_02_misalign/spike_misalign.py : Spike trap-on-misaligned checker for lw/lh/sh cases.
flow/v2_pipeline/phase_02_02_misalign/Makefile + linker scripts : build/run phase artifacts.
tests/gates/gate_02_02_misalign_trap.py : pytest gate for directed misalign phase.
tests/gates/gate_03_08_lockstep_revalidate.py : pytest gate that clean rebuilds/reruns phase_03_05.
## evidence
RTL events: lw pc=00000030 mcause=00000004 mtval=0000006d; lh pc=0000003c mcause=00000004 mtval=0000006d; sh pc=0000004c mcause=00000006 mtval=0000006d.
Aligned lb/sb marker observed before traps; TB reported no misaligned DBUS request.
Spike: lw mcause=4 mtval=0x80000011; lh mcause=4 mtval=0x80000011; sh mcause=6 mtval=0x80000015.
Lockstep revalidate: random lockstep matched 81 commits after clean rebuild with -Wno-PINMISSING.
## gate_status
python3 -m pytest tests/gates/gate_*.py -q : 163 passed.
## issues_or_waivers
none.
## tokens
not available from session tooling; get_goal returned no token accounting.
