Hans-Wis/Magpie_M3V/flow/v2_pipeline/phase_p_coremark/result.md

# Magpie_M1 CoreMark Result

- Status: completed
- Correct operation validated: yes
- Iterations: 1
- Total cycles: 371729
- Retired instructions in timed region: 289600
- CoreMark/MHz: 2.690132
- Implied CoreMark at 699 MHz: 1880.402
- Cycles per iteration: 371729.000
- IPC: 0.779062
- CPI: 1.283595

## Testbench Timed-Region Counters

- TB cycles: 371762
- TB committed instructions: 289627
- TB IPC: 0.779066
- TB CPI: 1.283589
- Load-use stall cycles: 20523
- Mul/div stall cycles: 37584
- Fetch/cross-boundary stall cycles: 8891
- Redirect/refetch cycles: 10037
- Other stall cycles: 0
- Compiler: riscv-none-elf-gcc 13.2.0-2 xPack
- Compiler flags: `-O2 -funroll-loops -fno-common -fno-builtin -march=rv32imc -mabi=ilp32 -ffreestanding -nostartfiles -nostdlib -DITERATIONS=1 -DTOTAL_DATA_SIZE=2000 -DPERFORMANCE_RUN=1 -DMEM_METHOD=MEM_STATIC`
- RTL changes: none

## Log Pointers

- Build/run log: `sim.log`
- Firmware disassembly: `firmware.disasm`
- Firmware map: `firmware.map`
