Hans-Wis/Magpie_M3V/docs/reports/Magpie_M3V_Performance.html

Performance Brief Magpie_M3V · RV32 NPU IP int8 edge inference

# Magpie_M3V NPU GEMM acceleration & MAC-array SKU performance

A synthesizable RV32 NPU IP for int8 ML inference (Gemma-3 / TFLM class). This brief summarizes the measured compute-offload acceleration and the configurable MAC-array area/power tiers. Every figure is measured on RTL against a bit-exact golden; power/area are from a real 28 nm synthesis flow.

Workload: Gemma-3 int8 projection GEMM Verification: bit-exact vs reference PPA: TSMC 28 nm, std-cell

5.5×

GEMM offload speedup vs the software-orchestrated baseline

near the memory floor

2,425

cycles / projection GEMM (from 13,350)

~2.4 µs @ 1 GHz

bit-exact

every output byte matches the int8 reference

512 / 512

64·128·256

MAC-array SKU tiers (customer-selectable)

area / power scaled

## ACCELERATIONGEMM offload — measured trajectory

A single int8 projection GEMM (q‑proj: 8×64 activations · 64×64 weights, the unit that repeats across the model). The bars are measured cycles; each stage removes a distinct overhead until the path reaches the memory-bandwidth floor.

Baselinefirmware-driven

13,350 cyc

HW sequencerPhase A

4,282

3.12×

+ act-residentPhase B1

3,403

3.9×

+ tight layoutPhase B1.1

2,425

5.5×

Memory floorweights must stream

~2,200

~6×

Bars scaled to the 13,350-cycle baseline. Floor = the irreducible weight-streaming cost + compute; the offload path reaches within ~10% of it.

## WHYWhere the cycles went

The baseline cost is dominated by per-tile software orchestration, not compute. The acceleration removes that overhead, then trims redundant data movement — the actual matrix compute is unchanged throughout (proving identical results).

BASELINE 13,350 cyc

orchestration 9,052

DMA 3,408

SW orchestration Data movement Matrix compute

ACCELERATED 2,425 cyc

DMA 1,539

compute 680

206 (was 9,052) 1,539 (was 3,408) 680 (unchanged)

Software orchestration 9,052 → 206 cycles (44× lower) via the hardware tile sequencer; data movement 3,408 → 1,539 by keeping activations resident and packing weight descriptors. Matrix compute is identical (680) — the accelerated path is bit-exact.

## DETAILPer-stage measured breakdown

Stage | What it adds | Cycles | Speedup | DMA
Baseline | Firmware issues each tile op & spin-waits | 13,350 | 1.0× | 3,408
Phase A | Hardware GEMM tile sequencer (no per-tile firmware) | 4,282 | 3.12× | 3,408
Phase B1 | Activation loaded once, resident (not per tile) | 3,403 | 3.92× | 2,515
Phase B1.1 | Tight descriptor layout (padding removed) | 2,425 | 5.5× | 1,539

Compute (680) constant across all stages · every stage verified bit-exact vs the int8 reference.

## SKUMAC-array tiers — area / power, customer-selectable

The MAC array is a synthesis-time parameter. Because typical edge inference (batch-1 token decode) is memory-bandwidth-bound, a smaller array runs it at nearly the same speed with materially lower area and power — while a larger array serves compute-heavy (prefill / batched) workloads. All tiers are bit-exact and meet the same clock.

SKU | MAC / cyc | Area | vs 256 | Power | vs 256 | Best for
Magpie‑256 | 256 | 83,868 µm² | 1.00× | 50.8 mW | 1.00× | prefill / batched
Magpie‑128 | 128 | 61,644 µm² | 0.74× | 36.2 mW | 0.71× | balanced
Magpie‑64 | 64 | 50,515 µm² | 0.60× | 29.2 mW | 0.57× | edge / decode

TSMC 28 nm (28HPC+) standard-cell synthesis, common clock, timing met on all tiers. Area/power scale with the MAC tree; the accumulator + requant + control are fixed overhead.

## METHODHow these numbers are produced

## Correctness

Every accelerated path is run on the RTL and compared byte-for-byte to the int8 quantized reference. No result is accepted on inspection or a passing lint — only on a bit-exact match.

## Performance

Cycle counts are measured in RTL simulation (start→done), decomposed into compute / data-movement / control. Area and power come from a real Synopsys DC + TSMC 28 nm flow, not estimates.

## SCOPEReading these figures

- Representative dimensions. The GEMM trajectory is measured on a representative projection (K=64, N=64) at small sequence length — the mechanism is dimension-independent; absolute cycles scale with the model's layer sizes.
- Scope of the 5.5×. It is the compute-offload path for the matrix (GEMM) work — the dominant repeated primitive. Non-matrix (normalization, activation) runs on a separate vector path and is optimized independently.
- Floor is physical. Past ~5.5× the remaining cost is weight streaming from memory, which is bandwidth-bound; further gains come from bandwidth, not orchestration.
- All measured. Cycle figures are RTL-measured; PPA is real 28 nm synthesis. Projections, where any appear, are labeled as such in the underlying reports.

Magpie_M3V NPU IP — Performance Brief measured on RTL · bit-exact · TSMC 28 nm PPA
