Hans-Wis/Magpie_M3V/flow/v2_pipeline/phase_05_leader/J8_result.md

## summary
INCOMPLETE: bounded J10 rerun of seed 2026060801 matched 981 / 100000 target commits. This is not a 100k PASS.

## divergence
None observed in the bounded one-seed rerun. DUT stopped after 981 commits before sentinel ebreak; no first-fail artifact was produced for this rerun.

## isa_config
riscv-dv pyflow target rv32imc, gcc -march=rv32imc_zicsr_zifencei -mabi=ilp32, M-mode bare program. Excluded unsupported/randomized behavior with --no_load_store=1 --no_branch_jump=1 --no_csr_instr=1 --no_fence=1 --no_data_page=1 --no_ebreak=1; no A/F/D/V.

## throughput
Verilator. Single-seed rerun elapsed 11.70 sec, 981 matched commits, 83.85 commits/sec.

## files_added
flow/v2_pipeline/phase_03_09_riscvdv_lockstep/{run_riscvdv_lockstep.py,tb_riscvdv_lockstep.v,firmware.lds,config/m1_riscvdv/testlist.yaml,config/m1_riscvdv/riscv_core_setting.sv,riscvdv_lockstep_summary.json,runs/}; tests/gates/gate_03_09_riscvdv_lockstep.py.

## provenance
riscv-dv /home/edauser/project/SOC/Magpie_X6/vendored/riscv-dv. gcc: riscv-none-elf-gcc 13.2.0. Spike: /home/edauser/.local/bin/spike. Command: python3 flow/v2_pipeline/phase_03_09_riscvdv_lockstep/run_riscvdv_lockstep.py --start-seed 2026060801 --seeds 1 --instr-cnt 4000 --target-commits 100000 --max-cycles 2000000.

## gate_status
J10 will re-run pytest and requested gates. This J8 artifact records the bounded rerun only, not full large-scale closure.

## tokens
Not available from local runtime/API telemetry.
