Hans-Wis/Magpie_M3V/flow/v2_pipeline/phase_p_axi/formal_results.txt

  Summary Results
   Property Summary: FPV
   -----------------
   > Assertion
     - # found        : 18
     - # proven       : 18

   > Vacuity
     - # found        : 18
     - # non_vacuous  : 18

   > Constraint
     - # found        : 3

  List Results
   Property List:
   --------------
   > Assertion
     # Assertion: 18
     [   2] proven                   (non_vacuous)  -  axil_bridge_formal.unnamed$$_10
     [   3] proven                   (non_vacuous)  -  axil_bridge_formal.unnamed$$_11
     [   4] proven                   (non_vacuous)  -  axil_bridge_formal.unnamed$$_12
     [   5] proven                   (non_vacuous)  -  axil_bridge_formal.unnamed$$_13
     [   6] proven                   (non_vacuous)  -  axil_bridge_formal.unnamed$$_14
     [   7] proven                   (non_vacuous)  -  axil_bridge_formal.unnamed$$_15
     [   8] proven                   (non_vacuous)  -  axil_bridge_formal.unnamed$$_16
     [   9] proven                   (non_vacuous)  -  axil_bridge_formal.unnamed$$_17
     [  10] proven                   (non_vacuous)  -  axil_bridge_formal.unnamed$$_18
     [  11] proven                   (non_vacuous)  -  axil_bridge_formal.unnamed$$_19
     [  12] proven                   (non_vacuous)  -  axil_bridge_formal.unnamed$$_20
     [  13] proven                   (non_vacuous)  -  axil_bridge_formal.unnamed$$_3
     [  14] proven                   (non_vacuous)  -  axil_bridge_formal.unnamed$$_4
     [  15] proven                   (non_vacuous)  -  axil_bridge_formal.unnamed$$_5
     [  16] proven                   (non_vacuous)  -  axil_bridge_formal.unnamed$$_6
     [  17] proven                   (non_vacuous)  -  axil_bridge_formal.unnamed$$_7
     [  18] proven                   (non_vacuous)  -  axil_bridge_formal.unnamed$$_8
     [  19] proven                   (non_vacuous)  -  axil_bridge_formal.unnamed$$_9

   > Constraint
     # Constraint: 3
     [   0] constrained                             -  axil_bridge_formal.unnamed$$_0
     [   1] constrained                             -  axil_bridge_formal.unnamed$$_1
     [  20] constrained                             -  constant_20 - resetn==1
