Hans-Wis/Magpie_M3V/flow/v2_pipeline/phase_p_archtest/results.csv

extension | test | status | sig_words | detail | source
RV32C | cadd-01 | PASS | 587 | signature match | /home/edauser/project/RISC-V/reference/ibex/vendor/riscv-arch-tests/riscv-test-suite/rv32i_m/C/src/cadd-01.S
RV32C | caddi-01 | PASS | 377 | signature match | /home/edauser/project/RISC-V/reference/ibex/vendor/riscv-arch-tests/riscv-test-suite/rv32i_m/C/src/caddi-01.S
RV32C | caddi16sp-01 | PASS | 71 | signature match | /home/edauser/project/RISC-V/reference/ibex/vendor/riscv-arch-tests/riscv-test-suite/rv32i_m/C/src/caddi16sp-01.S
RV32C | caddi4spn-01 | PASS | 22 | signature match | /home/edauser/project/RISC-V/reference/ibex/vendor/riscv-arch-tests/riscv-test-suite/rv32i_m/C/src/caddi4spn-01.S
RV32C | cand-01 | PASS | 588 | signature match | /home/edauser/project/RISC-V/reference/ibex/vendor/riscv-arch-tests/riscv-test-suite/rv32i_m/C/src/cand-01.S
RV32C | candi-01 | PASS | 378 | signature match | /home/edauser/project/RISC-V/reference/ibex/vendor/riscv-arch-tests/riscv-test-suite/rv32i_m/C/src/candi-01.S
RV32C | cbeqz-01 | PASS | 87 | signature match | /home/edauser/project/RISC-V/reference/ibex/vendor/riscv-arch-tests/riscv-test-suite/rv32i_m/C/src/cbeqz-01.S
RV32C | cbnez-01 | PASS | 87 | signature match | /home/edauser/project/RISC-V/reference/ibex/vendor/riscv-arch-tests/riscv-test-suite/rv32i_m/C/src/cbnez-01.S
RV32C | cebreak-01 | PASS | 8 | signature match | /home/edauser/project/RISC-V/reference/ibex/vendor/riscv-arch-tests/riscv-test-suite/rv32i_m/C/src/cebreak-01.S
RV32C | cj-01 | PASS | 20 | signature match | /home/edauser/project/RISC-V/reference/ibex/vendor/riscv-arch-tests/riscv-test-suite/rv32i_m/C/src/cj-01.S
RV32C | cjal-01 | PASS | 20 | signature match | /home/edauser/project/RISC-V/reference/ibex/vendor/riscv-arch-tests/riscv-test-suite/rv32i_m/C/src/cjal-01.S
RV32C | cjalr-01 | PASS | 33 | signature match | /home/edauser/project/RISC-V/reference/ibex/vendor/riscv-arch-tests/riscv-test-suite/rv32i_m/C/src/cjalr-01.S
RV32C | cjr-01 | PASS | 33 | signature match | /home/edauser/project/RISC-V/reference/ibex/vendor/riscv-arch-tests/riscv-test-suite/rv32i_m/C/src/cjr-01.S
RV32C | cli-01 | PASS | 34 | signature match | /home/edauser/project/RISC-V/reference/ibex/vendor/riscv-arch-tests/riscv-test-suite/rv32i_m/C/src/cli-01.S
RV32C | clui-01 | PASS | 33 | signature match | /home/edauser/project/RISC-V/reference/ibex/vendor/riscv-arch-tests/riscv-test-suite/rv32i_m/C/src/clui-01.S
RV32C | clw-01 | PASS | 16 | signature match | /home/edauser/project/RISC-V/reference/ibex/vendor/riscv-arch-tests/riscv-test-suite/rv32i_m/C/src/clw-01.S
RV32C | clwsp-01 | PASS | 33 | signature match | /home/edauser/project/RISC-V/reference/ibex/vendor/riscv-arch-tests/riscv-test-suite/rv32i_m/C/src/clwsp-01.S
RV32C | cmv-01 | PASS | 87 | signature match | /home/edauser/project/RISC-V/reference/ibex/vendor/riscv-arch-tests/riscv-test-suite/rv32i_m/C/src/cmv-01.S
RV32C | cnop-01 | PASS | 16 | signature match | /home/edauser/project/RISC-V/reference/ibex/vendor/riscv-arch-tests/riscv-test-suite/rv32i_m/C/src/cnop-01.S
RV32C | cor-01 | PASS | 592 | signature match | /home/edauser/project/RISC-V/reference/ibex/vendor/riscv-arch-tests/riscv-test-suite/rv32i_m/C/src/cor-01.S
RV32C | cslli-01 | PASS | 88 | signature match | /home/edauser/project/RISC-V/reference/ibex/vendor/riscv-arch-tests/riscv-test-suite/rv32i_m/C/src/cslli-01.S
RV32C | csrai-01 | PASS | 89 | signature match | /home/edauser/project/RISC-V/reference/ibex/vendor/riscv-arch-tests/riscv-test-suite/rv32i_m/C/src/csrai-01.S
RV32C | csrli-01 | PASS | 87 | signature match | /home/edauser/project/RISC-V/reference/ibex/vendor/riscv-arch-tests/riscv-test-suite/rv32i_m/C/src/csrli-01.S
RV32C | csub-01 | PASS | 583 | signature match | /home/edauser/project/RISC-V/reference/ibex/vendor/riscv-arch-tests/riscv-test-suite/rv32i_m/C/src/csub-01.S
RV32C | csw-01 | PASS | 72 | signature match | /home/edauser/project/RISC-V/reference/ibex/vendor/riscv-arch-tests/riscv-test-suite/rv32i_m/C/src/csw-01.S
RV32C | cswsp-01 | PASS | 71 | signature match | /home/edauser/project/RISC-V/reference/ibex/vendor/riscv-arch-tests/riscv-test-suite/rv32i_m/C/src/cswsp-01.S
RV32C | cxor-01 | PASS | 585 | signature match | /home/edauser/project/RISC-V/reference/ibex/vendor/riscv-arch-tests/riscv-test-suite/rv32i_m/C/src/cxor-01.S
RV32I | add-01 | PASS | 590 | signature match | /home/edauser/project/RISC-V/reference/ibex/vendor/riscv-arch-tests/riscv-test-suite/rv32i_m/I/src/add-01.S
RV32I | addi-01 | PASS | 563 | signature match | /home/edauser/project/RISC-V/reference/ibex/vendor/riscv-arch-tests/riscv-test-suite/rv32i_m/I/src/addi-01.S
RV32I | and-01 | PASS | 586 | signature match | /home/edauser/project/RISC-V/reference/ibex/vendor/riscv-arch-tests/riscv-test-suite/rv32i_m/I/src/and-01.S
RV32I | andi-01 | PASS | 564 | signature match | /home/edauser/project/RISC-V/reference/ibex/vendor/riscv-arch-tests/riscv-test-suite/rv32i_m/I/src/andi-01.S
RV32I | auipc-01 | PASS | 66 | signature match | /home/edauser/project/RISC-V/reference/ibex/vendor/riscv-arch-tests/riscv-test-suite/rv32i_m/I/src/auipc-01.S
RV32I | beq-01 | PASS | 585 | signature match | /home/edauser/project/RISC-V/reference/ibex/vendor/riscv-arch-tests/riscv-test-suite/rv32i_m/I/src/beq-01.S
RV32I | bge-01 | PASS | 592 | signature match | /home/edauser/project/RISC-V/reference/ibex/vendor/riscv-arch-tests/riscv-test-suite/rv32i_m/I/src/bge-01.S
RV32I | bgeu-01 | PASS | 728 | signature match | /home/edauser/project/RISC-V/reference/ibex/vendor/riscv-arch-tests/riscv-test-suite/rv32i_m/I/src/bgeu-01.S
RV32I | blt-01 | PASS | 582 | signature match | /home/edauser/project/RISC-V/reference/ibex/vendor/riscv-arch-tests/riscv-test-suite/rv32i_m/I/src/blt-01.S
RV32I | bltu-01 | PASS | 728 | signature match | /home/edauser/project/RISC-V/reference/ibex/vendor/riscv-arch-tests/riscv-test-suite/rv32i_m/I/src/bltu-01.S
RV32I | bne-01 | PASS | 586 | signature match | /home/edauser/project/RISC-V/reference/ibex/vendor/riscv-arch-tests/riscv-test-suite/rv32i_m/I/src/bne-01.S
RV32I | fence-01 | PASS | 3 | signature match | /home/edauser/project/RISC-V/reference/ibex/vendor/riscv-arch-tests/riscv-test-suite/rv32i_m/I/src/fence-01.S
RV32I | jal-01 | PASS | 34 | signature match | /home/edauser/project/RISC-V/reference/ibex/vendor/riscv-arch-tests/riscv-test-suite/rv32i_m/I/src/jal-01.S
RV32I | jalr-01 | PASS | 35 | signature match | /home/edauser/project/RISC-V/reference/ibex/vendor/riscv-arch-tests/riscv-test-suite/rv32i_m/I/src/jalr-01.S
RV32I | lb-align-01 | PASS | 35 | signature match | /home/edauser/project/RISC-V/reference/ibex/vendor/riscv-arch-tests/riscv-test-suite/rv32i_m/I/src/lb-align-01.S
RV32I | lbu-align-01 | PASS | 34 | signature match | /home/edauser/project/RISC-V/reference/ibex/vendor/riscv-arch-tests/riscv-test-suite/rv32i_m/I/src/lbu-align-01.S
RV32I | lh-align-01 | PASS | 34 | signature match | /home/edauser/project/RISC-V/reference/ibex/vendor/riscv-arch-tests/riscv-test-suite/rv32i_m/I/src/lh-align-01.S
RV32I | lhu-align-01 | PASS | 34 | signature match | /home/edauser/project/RISC-V/reference/ibex/vendor/riscv-arch-tests/riscv-test-suite/rv32i_m/I/src/lhu-align-01.S
RV32I | lui-01 | PASS | 65 | signature match | /home/edauser/project/RISC-V/reference/ibex/vendor/riscv-arch-tests/riscv-test-suite/rv32i_m/I/src/lui-01.S
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
RV32M | remu-01 | PASS | 726 | signature match | /home/edauser/project/RISC-V/reference/ibex/vendor/riscv-arch-tests/riscv-test-suite/rv32i_m/M/src/remu-01.S
