Hans-Wis/Magpie_M3V/flow/v2_pipeline/phase_p_axi/archtest_axi_results.csv

extension | test | status | detail
RV32I | add-01 | PASS | signature match at waits 0,3
RV32M | mul-01 | PASS | signature match at waits 0,3
