Hans-Wis/Magpie_M3V/flow/v2_pipeline/phase_03_07_muldiv_hazard/muldiv_hazard_report.md

# Phase 3.7 Mul/Div Hazard Lockstep Report

Status: pass

Result: muldiv hazard lockstep matched 45 commits

Compared fields: `pc`, `instr`, `rd`, `wdata`.

Scope: directed mul/div stall, result-latch, forwarding, load-use, divide-by-zero, and overflow regression. This is not random DV or coverage closure.
