Hans-Wis/Magpie_M3V/flow/fpga/pynq_z2/synth_pynq.xdc

# PYNQ-Z2 (xc7z020clg400-1) Magpie_M1 LED demo

set_property -dict { PACKAGE_PIN H16 IOSTANDARD LVCMOS33 } [get_ports clk]
create_clock -period 20.000 -name sys_clk_pin [get_ports clk]

set_property -dict { PACKAGE_PIN D19 IOSTANDARD LVCMOS33 } [get_ports btn0]

set_property -dict { PACKAGE_PIN R14 IOSTANDARD LVCMOS33 } [get_ports {led[0]}]
set_property -dict { PACKAGE_PIN P14 IOSTANDARD LVCMOS33 } [get_ports {led[1]}]
set_property -dict { PACKAGE_PIN N16 IOSTANDARD LVCMOS33 } [get_ports {led[2]}]
set_property -dict { PACKAGE_PIN M14 IOSTANDARD LVCMOS33 } [get_ports {led[3]}]
