Hans-Wis/Magpie_M3V/design/npu/sw/host_deploy/host_deploy.c

/* gate_88 deploy smoke (ADR-0069 Step C): ONE firmware exercises the deploy
 * main path end-to-end from XIP flash — UART banner -> CLINT timer tick ->
 * full q_proj CQ offload -> DONE. IRQ-depth for UART/CLINT lives in gate_87;
 * here the timer is mip.MTIP-polled to keep the smoke linear and diagnosable.
 * Offload body mirrors host_producer.c (same descriptors, same golden tile). */
#include <stdint.h>

#define NPU_BASE        0x30000000u
#define SHARED_BASE     0x80000000u
#define DONE_ADDR       (SHARED_BASE + 0x0000FF00u)
#define DONE_PASS       0x534F4350u
#define DONE_FAIL       0x534F4346u

#define A_CTRL          (NPU_BASE + 0x04u)
#define A_STATUS        (NPU_BASE + 0x08u)
#define A_BASE          (NPU_BASE + 0x40u)
#define A_SIZE          (NPU_BASE + 0x44u)
#define A_TAIL          (NPU_BASE + 0x4Cu)
#define A_CQCTRL        (NPU_BASE + 0x50u)
#define A_CQST          (NPU_BASE + 0x54u)
#define A_ERRC          (NPU_BASE + 0x58u)

#define UART_THR        0x10000000u
#define UART_LSR        0x10000014u
#define UART_LSR_THRE   (1u << 5)

#define CLINT_MTIMECMP_L 0x02004000u
#define CLINT_MTIMECMP_H 0x02004004u
#define CLINT_MTIME_L    0x0200BFF8u
#define MIP_MTIP         (1u << 7)

static inline void store32(uint32_t addr, uint32_t data)
{
    *(volatile uint32_t *)addr = data;
}

static inline uint32_t load32(uint32_t addr)
{
    return *(volatile uint32_t *)addr;
}

static inline void fence_all(void)
{
    __asm__ volatile ("fence iorw, iorw" ::: "memory");
}

static inline uint32_t read_mip(void)
{
    uint32_t value;
    __asm__ volatile ("csrr %0, mip" : "=r"(value));
    return value;
}

#include "npu_fw_load.inc"

static inline uint32_t pack_a(uint32_t base)
{
    uint32_t w = 0;
    for (uint32_t j = 0; j < 4; j++) {
        uint32_t idx = base + j;
        w |= (((idx * 7u - 100u) & 0xFFu) << (8u * j));
    }
    return w;
}

static inline uint32_t pack_b(uint32_t base)
{
    uint32_t w = 0;
    for (uint32_t j = 0; j < 4; j++) {
        uint32_t idx = base + j;
        w |= (((idx * 5u - 60u) & 0xFFu) << (8u * j));
    }
    return w;
}

static void fail(uint32_t stage, uint32_t evidence)
{
    store32(DONE_ADDR + 4u, stage);
    store32(DONE_ADDR + 8u, evidence);
    store32(DONE_ADDR, DONE_FAIL);
    for (;;) { }
}

static void uart_putc(uint8_t ch)
{
    while ((load32(UART_LSR) & UART_LSR_THRE) == 0u) { }
    store32(UART_THR, (uint32_t)ch);
}

int main(void)
{
    uint32_t i;

    /* 1. deploy banner over UART (TB scoreboards the exact bytes) */
    uart_putc('D');
    uart_putc('P');
    uart_putc('L');
    uart_putc('\n');

    /* 2. CLINT timer tick: MTIP must be clean, fire once, then park */
    if ((read_mip() & MIP_MTIP) != 0u)
        fail(1u, read_mip());
    store32(CLINT_MTIMECMP_H, 0xFFFFFFFFu);
    store32(CLINT_MTIMECMP_L, load32(CLINT_MTIME_L) + 64u);
    store32(CLINT_MTIMECMP_H, 0u);
    for (i = 0; i < 200000u; i++) {
        if ((read_mip() & MIP_MTIP) != 0u)
            break;
    }
    if ((read_mip() & MIP_MTIP) == 0u)
        fail(2u, load32(CLINT_MTIME_L));
    store32(CLINT_MTIMECMP_H, 0xFFFFFFFFu);   /* park far away, MTIP drops */

    /* 3. full q_proj CQ offload (same contract as host_producer.c) */
    load_npu_firmware();

    for (i = 0; i < 8; i++)
        store32(0x30010700u + (i * 4u), pack_a(i * 4u));
    for (i = 0; i < 8; i++)
        store32(0x30010740u + (i * 4u), pack_b(i * 4u));

    store32(SHARED_BASE + 0x0400u, 0x00000001u);
    store32(SHARED_BASE + 0x0404u, 0x00080008u);
    store32(SHARED_BASE + 0x0408u, 32u);
    store32(SHARED_BASE + 0x040Cu, 0u);
    store32(SHARED_BASE + 0x0410u, 0x00000006u);
    store32(SHARED_BASE + 0x0414u, 1u);
    store32(SHARED_BASE + 0x0418u, 0u);
    store32(SHARED_BASE + 0x041Cu, 0u);
    store32(SHARED_BASE + 0x0420u, 0x00040003u);
    store32(SHARED_BASE + 0x0424u, 0x00000700u);
    store32(SHARED_BASE + 0x0428u, 0x00000740u);
    store32(SHARED_BASE + 0x042Cu, 0u);
    store32(SHARED_BASE + 0x0430u, 0x00000004u);
    store32(SHARED_BASE + 0x0434u, 0x54C4699Au);
    store32(SHARED_BASE + 0x0438u, 0x00008026u);
    store32(SHARED_BASE + 0x043Cu, 0x00007F80u);
    store32(SHARED_BASE + 0x0440u, 0x00005005u);
    store32(SHARED_BASE + 0x0444u, 0x00001800u);
    store32(SHARED_BASE + 0x0448u, 0x00000800u);
    store32(SHARED_BASE + 0x044Cu, 0x00000404u);

    fence_all();
    store32(A_BASE, 0x00000400u);
    store32(A_SIZE, 8u);
    store32(A_CQCTRL, 1u);
    store32(A_CTRL, 0x9u);
    fence_all();
    store32(A_TAIL, 5u);

    for (i = 0; i < 2000000u; i++) {
        uint32_t st = load32(A_STATUS);
        if (st & 0x2u) {
            uint32_t cqst = load32(A_CQST);
            if (cqst & 0x8u)
                fail(6u, load32(A_ERRC));
            (void)load32(SHARED_BASE + 0x1800u);
            uart_putc('O');
            uart_putc('K');
            uart_putc('\n');
            store32(DONE_ADDR + 4u, st);
            store32(DONE_ADDR + 8u, cqst);
            store32(DONE_ADDR, DONE_PASS);
            for (;;) { }
        }
    }

    fail(5u, load32(A_STATUS));
    return 0;
}
