Hans-Wis/Magpie_M3V/design/cpu_m1/rtl/csr.v

// =============================================================================
// csr.v — Lab05 RISC-V M-mode Control & Status Register file
// -----------------------------------------------------------------------------
// 內含：
//   * 7 個 RW CSR (mstatus / mie / mtvec / mscratch / mepc / mcause / mip*)
//     [* mip 對外是 read-only；只受硬體 irq + trap entry 控制]
//   * 4 個 RO counter CSR (cycle / cycleh / instret / instreth)
//   * 中斷 pending 邏輯 (irq_pending = ext_pending & MIE & MEIE)
//
// 與 core.v 的介面 (CSR 讀寫一律在 WB state 同一拍完成)：
//   csr_addr/op/wdata/we  → 寫 CSR (op = W/S/C，wdata = rs1 或 zimm)
//   csr_rdata             ← 組合讀 (回 OLD 值，給 rd 寫回)
//   instr_retired         → 每條完成 1 cycle pulse，instret++
//   trap_enter + trap_pc  → 進中斷：mepc <- trap_pc, mcause<-EXT, MPIE<-MIE, MIE<-0
//   trap_exit (mret)      → 退中斷：MIE <- MPIE, MPIE <- 1
//   irq_external_pulse    → BTN1 debounced 上緣，set ext_pending
//   mtvec_o / mepc_o      ← 給 IFU 做 next_pc 用
//   irq_pending           ← 給 core 在 WB 判斷是否要 trap entry
//
// 教學說明：
//   * cycle / instret 是 RO；寫入 (e.g. csrrw 試圖寫) 被忽略，不 trap
//   * 「未實作」CSR 讀回 0、寫忽略，避免 boot code 隨便讀 mhartid 就 trap
//   * MEIE/MIE/MPIE/MEIP 用 named bit-position (def.vh) 而不是 magic number
//   * mtvec direct mode only (MODE bits 寫入被遮蔽成 0)
//   * mip[11] 是「外部中斷已發生但尚未進 ISR」的硬體 sticky bit；
//     軟體不需要清 (進 trap 時硬體自動清)
// =============================================================================

`include "def.vh"

module csr #(
    parameter RV32A = 0,
    parameter PMP_ENTRIES = 0,
    parameter EN_RVV = 0,
    parameter EN_F = 0
) (
    input             clk,
    input             resetn,

    // CSR read port (combinational, ID/EX stage 用)
    input  [11:0]     csr_raddr,
    output reg [31:0] csr_rdata,

    // CSR write port (sync, EX/WB stage 用；可與 raddr 不同)
    input             csr_we,
    input  [11:0]     csr_waddr,
    input  [ 1:0]     csr_op,        // CSR_OP_W/S/C
    input  [31:0]     csr_wdata,     // 直接寫入用 / set 用 mask / clear 用 mask
    input  [31:0]     csr_old_val,   // = ex_wb 階段已 latch 的 OLD 值 (pipeline 用)

    // RVV Stage 3A architectural config commit (from core WB boundary)
    input             vcfg_we,
    input  [31:0]     vcfg_vl,
    input  [31:0]     vcfg_vtype,
    // RVV Stage 3B: a vector-execute instruction committed at WB
    // (clears vstart, sets mstatus.VS dirty — atomic with the VRF write)
    input             vexec_we,
    // ADR-0050 F: fexec commit at WB (fflags accrual + mstatus.FS dirty)
    input             fexec_we,
    input  [4:0]      fflags_set,
    output [ 2:0]     frm_o,

    // Counter input
    input             instr_retired,

    // Trap entry (from core, single-cycle pulse in WB)
    input             trap_enter,
    input  [31:0]     trap_pc,       // pc to save in mepc (next_pc that would have executed)
    input  [31:0]     trap_cause,
    input  [31:0]     trap_mtval,

    // Trap exit (mret)
    input             trap_exit,

    // Debug-mode CSRs / abstract CSR access (ADR-0021; adapted from
    // Magpie_X1 rtl/cpu/csru.v dcsr/dpc/dscratch0, narrowed to RV32).
    input             debug_csr_we,
    input  [11:0]     debug_csr_waddr,
    input  [31:0]     debug_csr_wdata,
    output [31:0]     debug_csr_rdata,
    input             debug_halt_enter,
    input  [31:0]     debug_halt_pc,
    input  [ 2:0]     debug_halt_cause,
    output [31:0]     dpc_o,
    output            dcsr_step_o,
    output            dcsr_ebreakm_o,

    // Trigger CSRs (ADR-0022; storage/matching lives in trigger.v)
    input  [31:0]     trigger_csr_rdata,
    input  [31:0]     trigger_debug_csr_rdata,
    output            trigger_csr_we,
    output [11:0]     trigger_csr_waddr,
    output [31:0]     trigger_csr_wdata,
    output            trigger_debug_csr_we,
    output [11:0]     trigger_debug_csr_waddr,
    output [31:0]     trigger_debug_csr_wdata,

    // External IRQ source (single-cycle pulse from debouncer)
    input             irq_external_pulse,

    // CLINT interrupt sources (level, CLINT-sourced; ADR-0019). 0 if no CLINT wired.
    input             mtip,             // mip[7]: mtime >= mtimecmp
    input             msip,             // mip[3]: software interrupt

    // PLIC external interrupt (level, ADR-0020). 0 if no PLIC; legacy irq_external_pulse still ORs in.
    input             meip,             // mip[11] level source (PLIC.meip_o)

    // To IFU / core
    output [31:0]     mtvec_o,
    output [31:0]     mepc_o,
    output            irq_pending,
    output [31:0]     irq_cause,        // priority-encoded interrupt mcause (MEI>MSI>MTI)

    // RVV state exported for vset*/vexu EX calculation and privilege checks
    output [ 1:0]     mstatus_vs_o,
    output [ 1:0]     mstatus_fs_o,
    output [31:0]     mstatus_o,        // ADR-0048: architectural mstatus read view
    output [31:0]     vl_o,
    output [31:0]     vtype_o,
    output [31:0]     vstart_o,
    output [ 1:0]     vxrm_o,            // S2 (ADR-0049)
    input             vxsat_set,         // S2: vector op saturated at WB

    // PMP CSRs (ADR-0024). Flattened as 8 entries so PMP_ENTRIES=0/4/8 can share ports.
    output [32*8-1:0] pmp_addr_o,
    output [ 8*8-1:0] pmp_cfg_o
);

    // -------------------------------------------------------------------------
    // 1. CSR register storage
    // -------------------------------------------------------------------------
    reg        mie_meie;        // mie[11]
    reg        mie_mtie;        // mie[7]  (ADR-0019)
    reg        mie_msie;        // mie[3]  (ADR-0019)
    reg        mstatus_mie;     // mstatus[3]
    reg        mstatus_mpie;    // mstatus[7]
    reg [ 1:0] mstatus_vs;      // mstatus[10:9], RVV vector state status (WARL 0..3 when EN_RVV)
    localparam [1:0] mstatus_mpp = 2'b11;  // mstatus[12:11] read-only WARL=M (M-only hart; ADR-0015)
    reg [31:2] mtvec_base;      // mtvec[31:2] (MODE 永遠 0)
    reg [31:0] mscratch;
    reg [31:0] mepc_reg;
    reg [31:0] mcause_reg;
    reg [31:0] mtval_reg;
    reg        ext_pending;     // mip[11], hardware managed
    reg [31:0] dpc_reg;
    reg [31:0] dscratch0_reg;
    reg        dcsr_step_reg;
    reg        dcsr_ebreakm_reg;
    reg [ 2:0] dcsr_cause_reg;
    reg [ 6:0] vstart_reg;
    reg        vxsat_reg;
    reg [4:0]  fflags_reg;      // ADR-0050
    reg [2:0]  frm_reg;
    reg [1:0]  mstatus_fs;      // mstatus[14:13]
    reg [ 1:0] vxrm_reg;
    reg [31:0] vl_reg;
    reg [31:0] vtype_reg;
    reg [ 7:0] pmpcfg_r [0:7];
    reg [31:0] pmpaddr_r [0:7];

    // Counters
    reg [63:0] cycle_cnt;
    reg [63:0] instret_cnt;

    reg [31:0] new_val;
    integer pmp_i;

    function is_trigger_csr;
        input [11:0] addr;
        begin
            is_trigger_csr = (addr == `CSR_TSELECT) ||
                             (addr == `CSR_TDATA1)  ||
                             (addr == `CSR_TDATA2)  ||
                             (addr == `CSR_TINFO);
        end
    endfunction

    function is_pmpcfg_csr;
        input [11:0] addr;
        begin
            is_pmpcfg_csr = (PMP_ENTRIES != 0) &&
                            ((addr == `CSR_PMPCFG0) ||
                             ((PMP_ENTRIES > 4) && (addr == `CSR_PMPCFG1)));
        end
    endfunction

    function is_pmpaddr_csr;
        input [11:0] addr;
        begin
            is_pmpaddr_csr = (PMP_ENTRIES != 0) &&
                             (addr >= `CSR_PMPADDR0) &&
                             (addr < (`CSR_PMPADDR0 + PMP_ENTRIES));
        end
    endfunction

    function [2:0] pmp_index;
        input [11:0] addr;
        begin
            pmp_index = addr[2:0];
        end
    endfunction

    function [31:0] pmpcfg_read;
        input [11:0] addr;
        integer base;
        begin
            base = (addr == `CSR_PMPCFG1) ? 4 : 0;
            pmpcfg_read = {pmpcfg_r[base + 3], pmpcfg_r[base + 2],
                           pmpcfg_r[base + 1], pmpcfg_r[base + 0]};
        end
    endfunction

    function is_vector_csr;
        input [11:0] addr;
        begin
            is_vector_csr = (addr == `CSR_VSTART) ||
                            (addr == `CSR_VXSAT)  ||
                            (addr == `CSR_VXRM)   ||
                            (addr == `CSR_VCSR)   ||
                            (addr == `CSR_VL)     ||
                            (addr == `CSR_VTYPE)  ||
                            (addr == `CSR_VLENB);
        end
    endfunction

    // -------------------------------------------------------------------------
    // 2. Read mux (組合)
    //   未列出的位址回 0 (mhartid / misa / mvendorid 等)
    // -------------------------------------------------------------------------
    wire [1:0]  mstatus_vs_visible = (EN_RVV != 0) ? mstatus_vs : 2'b00;
    wire [1:0]  mstatus_fs_visible = (EN_F != 0) ? mstatus_fs : 2'b00;
    wire        mstatus_sd = ((EN_RVV != 0) && (mstatus_vs == 2'b11)) ||
                             ((EN_F   != 0) && (mstatus_fs == 2'b11));
    // mstatus layout: [31]=SD, [12:11]=MPP, [10:9]=VS, [7]=MPIE, [3]=MIE
    wire [31:0] mstatus_val = {mstatus_sd, 16'b0, mstatus_fs_visible, mstatus_mpp,
                               mstatus_vs_visible, 1'b0, mstatus_mpie, 3'b0,
                               mstatus_mie, 3'b0};
    // mie/mip layout: [11]=MEIE/MEIP, [7]=MTIE/MTIP, [3]=MSIE/MSIP (ADR-0019)
    wire [31:0] mie_val     = {20'b0, mie_meie, 3'b0, mie_mtie, 3'b0, mie_msie, 3'b0};
    assign mstatus_o = mstatus_val;
    wire [31:0] mip_val     = {20'b0, (ext_pending | meip), 3'b0, mtip, 3'b0, msip, 3'b0};
    wire [31:0] mtvec_val   = {mtvec_base, 2'b00};
    wire [31:0] mtval_val   = mtval_reg;
    wire [31:0] vstart_val  = {25'b0, vstart_reg};
    wire [31:0] vxsat_val   = {31'b0, vxsat_reg};
    wire [31:0] vxrm_val    = {30'b0, vxrm_reg};
    wire [31:0] vcsr_val    = {29'b0, vxrm_reg, vxsat_reg};
    wire [31:0] fcsr_val    = {24'b0, frm_reg, fflags_reg};
    assign frm_o = (EN_F != 0) ? frm_reg : 3'b0;
    wire [31:0] vlenb_val   = 32'd16;
    // M1A A2 (ADR-0026): + misa.B (bit1) — Zba+Zbb+Zbs ratified as B; Spike --priv=m parity = 0x40001106
    localparam [25:0] MISA_EXT_BASE = (26'h1 << 8) | (26'h1 << 12) | (26'h1 << 2) | (26'h1 << 1);
    wire [31:0] misa_val    = {2'b01, 4'b0, (MISA_EXT_BASE | ((RV32A != 0) ? 26'h1 : 26'h0))};
    wire [31:0] dcsr_val    = {4'h4, 12'h0, dcsr_ebreakm_reg, 3'h0, 1'b0, 2'b0,
                               dcsr_cause_reg, 3'h0, dcsr_step_reg, 2'b11};

    function [31:0] csr_debug_read;
        input [11:0] addr;
        begin
            case (addr)
                `CSR_MSTATUS : csr_debug_read = mstatus_val;
                `CSR_MISA    : csr_debug_read = misa_val;
                `CSR_MIE     : csr_debug_read = mie_val;
                `CSR_MTVEC   : csr_debug_read = mtvec_val;
                `CSR_MSCRATCH: csr_debug_read = mscratch;
                `CSR_MEPC    : csr_debug_read = mepc_reg;
                `CSR_MCAUSE  : csr_debug_read = mcause_reg;
                `CSR_MTVAL   : csr_debug_read = mtval_val;
                `CSR_MIP     : csr_debug_read = mip_val;
                `CSR_VSTART  : csr_debug_read = (EN_RVV != 0) ? vstart_val : 32'h0;
                `CSR_FFLAGS  : csr_debug_read = (EN_F != 0) ? {27'b0, fflags_reg} : 32'h0;
                `CSR_FRM     : csr_debug_read = (EN_F != 0) ? {29'b0, frm_reg} : 32'h0;
                `CSR_FCSR    : csr_debug_read = (EN_F != 0) ? fcsr_val : 32'h0;
                `CSR_VXSAT   : csr_debug_read = (EN_RVV != 0) ? vxsat_val : 32'h0;
                `CSR_VXRM    : csr_debug_read = (EN_RVV != 0) ? vxrm_val : 32'h0;
                `CSR_VCSR    : csr_debug_read = (EN_RVV != 0) ? vcsr_val : 32'h0;
                `CSR_VL      : csr_debug_read = (EN_RVV != 0) ? vl_reg : 32'h0;
                `CSR_VTYPE   : csr_debug_read = (EN_RVV != 0) ? vtype_reg : 32'h0;
                `CSR_VLENB   : csr_debug_read = (EN_RVV != 0) ? vlenb_val : 32'h0;
                `CSR_CYCLE   : csr_debug_read = cycle_cnt[31:0];
                `CSR_CYCLEH  : csr_debug_read = cycle_cnt[63:32];
                `CSR_INSTRET : csr_debug_read = instret_cnt[31:0];
                `CSR_INSTRETH: csr_debug_read = instret_cnt[63:32];
                `CSR_DCSR    : csr_debug_read = dcsr_val;
                `CSR_DPC     : csr_debug_read = dpc_reg;
                `CSR_DSCRATCH0: csr_debug_read = dscratch0_reg;
                `CSR_PMPCFG0,
                `CSR_PMPCFG1 : csr_debug_read = is_pmpcfg_csr(addr) ? pmpcfg_read(addr) : 32'h0;
                `CSR_PMPADDR0,
                `CSR_PMPADDR1,
                `CSR_PMPADDR2,
                `CSR_PMPADDR3,
                `CSR_PMPADDR4,
                `CSR_PMPADDR5,
                `CSR_PMPADDR6,
                `CSR_PMPADDR7: csr_debug_read = is_pmpaddr_csr(addr) ?
                                                pmpaddr_r[pmp_index(addr)] : 32'h0;
                `CSR_TSELECT,
                `CSR_TDATA1,
                `CSR_TDATA2,
                `CSR_TINFO   : csr_debug_read = trigger_debug_csr_rdata;
                default      : csr_debug_read = 32'h0;
            endcase
        end
    endfunction

    always @* begin
        case (csr_raddr)
            `CSR_MSTATUS : csr_rdata = mstatus_val;
            `CSR_MISA    : csr_rdata = misa_val;
            `CSR_MIE     : csr_rdata = mie_val;
            `CSR_MTVEC   : csr_rdata = mtvec_val;
            `CSR_MSCRATCH: csr_rdata = mscratch;
            `CSR_MEPC    : csr_rdata = mepc_reg;
            `CSR_MCAUSE  : csr_rdata = mcause_reg;
            `CSR_MTVAL   : csr_rdata = mtval_val;
            `CSR_MIP     : csr_rdata = mip_val;
            `CSR_VSTART  : csr_rdata = (EN_RVV != 0) ? vstart_val : 32'h0;
            `CSR_FFLAGS  : csr_rdata = (EN_F != 0) ? {27'b0, fflags_reg} : 32'h0;
            `CSR_FRM     : csr_rdata = (EN_F != 0) ? {29'b0, frm_reg} : 32'h0;
            `CSR_FCSR    : csr_rdata = (EN_F != 0) ? fcsr_val : 32'h0;
            `CSR_VXSAT   : csr_rdata = (EN_RVV != 0) ? vxsat_val : 32'h0;
            `CSR_VXRM    : csr_rdata = (EN_RVV != 0) ? vxrm_val : 32'h0;
            `CSR_VCSR    : csr_rdata = (EN_RVV != 0) ? vcsr_val : 32'h0;
            `CSR_VL      : csr_rdata = (EN_RVV != 0) ? vl_reg : 32'h0;
            `CSR_VTYPE   : csr_rdata = (EN_RVV != 0) ? vtype_reg : 32'h0;
            `CSR_VLENB   : csr_rdata = (EN_RVV != 0) ? vlenb_val : 32'h0;
            `CSR_CYCLE   : csr_rdata = cycle_cnt[31:0];
            `CSR_CYCLEH  : csr_rdata = cycle_cnt[63:32];
            `CSR_INSTRET : csr_rdata = instret_cnt[31:0];
            `CSR_INSTRETH: csr_rdata = instret_cnt[63:32];
            `CSR_DCSR    : csr_rdata = dcsr_val;
            `CSR_DPC     : csr_rdata = dpc_reg;
            `CSR_DSCRATCH0: csr_rdata = dscratch0_reg;
            `CSR_PMPCFG0,
            `CSR_PMPCFG1 : csr_rdata = is_pmpcfg_csr(csr_raddr) ? pmpcfg_read(csr_raddr) : 32'h0;
            `CSR_PMPADDR0,
            `CSR_PMPADDR1,
            `CSR_PMPADDR2,
            `CSR_PMPADDR3,
            `CSR_PMPADDR4,
            `CSR_PMPADDR5,
            `CSR_PMPADDR6,
            `CSR_PMPADDR7: csr_rdata = is_pmpaddr_csr(csr_raddr) ?
                                       pmpaddr_r[pmp_index(csr_raddr)] : 32'h0;
            `CSR_TSELECT,
            `CSR_TDATA1,
            `CSR_TDATA2,
            `CSR_TINFO   : csr_rdata = trigger_csr_rdata;
            default      : csr_rdata = 32'h0;
        endcase
        if (csr_we && (csr_waddr == csr_raddr)) begin
            case (csr_waddr)
                `CSR_MSTATUS,
                `CSR_MIE,
                `CSR_MTVEC,
                `CSR_MSCRATCH,
                `CSR_MEPC,
                `CSR_MCAUSE,
                `CSR_MTVAL,
                `CSR_FFLAGS,
                `CSR_FRM,
                `CSR_FCSR,
                `CSR_VSTART,
                `CSR_VXSAT,
                `CSR_VXRM,
                `CSR_VCSR,
                `CSR_DPC,
                `CSR_DSCRATCH0,
                `CSR_PMPCFG0,
                `CSR_PMPCFG1,
                `CSR_PMPADDR0,
                `CSR_PMPADDR1,
                `CSR_PMPADDR2,
                `CSR_PMPADDR3,
                `CSR_PMPADDR4,
                `CSR_PMPADDR5,
                `CSR_PMPADDR6,
                `CSR_PMPADDR7,
                `CSR_TSELECT,
                `CSR_TDATA1,
                `CSR_TDATA2,
                `CSR_TINFO: begin
                    if (is_trigger_csr(csr_waddr))
                        csr_rdata = trigger_csr_rdata;
                    else if (is_pmpcfg_csr(csr_waddr))
                        csr_rdata = new_val;
                    else if (is_pmpaddr_csr(csr_waddr))
                        csr_rdata = new_val;
                    else if ((EN_RVV != 0) && (csr_waddr == `CSR_VSTART))
                        csr_rdata = {25'b0, new_val[6:0]};
                    else if ((EN_RVV != 0) && (csr_waddr == `CSR_VXSAT))
                        csr_rdata = {31'b0, new_val[0]};
                    else if ((EN_RVV != 0) && (csr_waddr == `CSR_VXRM))
                        csr_rdata = {30'b0, new_val[1:0]};
                    else if ((EN_RVV != 0) && (csr_waddr == `CSR_VCSR))
                        csr_rdata = {29'b0, new_val[2:1], new_val[0]};
                    else
                        csr_rdata = new_val;
                end
                `CSR_DCSR: csr_rdata = {4'h4, 12'h0, new_val[15], 3'h0, 1'b0, 2'b0,
                                        new_val[8:6], 3'h0, new_val[2], 2'b11};
                // verilator coverage_off
                default: ;
                // verilator coverage_on
                // ^ CS-COV-1 exclusion: every writable CSR is in the bypass list; reachable only via RO-addr writes which trap — CS-COV-1
            endcase
        end
        if ((EN_RVV != 0) && vcfg_we) begin
            case (csr_raddr)
                `CSR_VSTART: csr_rdata = 32'h0;
                `CSR_VL    : csr_rdata = vcfg_vl;
                `CSR_VTYPE : csr_rdata = vcfg_vtype;
                default    : ;
            endcase
        end
        // ADR-0036 3A: same-cycle WB-write forwarding for the vxsat/vxrm/vcsr
        // ALIAS group and for mstatus.VS side effects. The exact-address bypass
        // above cannot see a write to a *different alias of the same physical
        // state* (caught by gate_40 lockstep: csrw vxsat; ...; csrr vcsr).
        if ((EN_RVV != 0) && csr_we && (csr_waddr != csr_raddr)) begin
            case (csr_raddr)
                `CSR_VCSR: begin
                    if (csr_waddr == `CSR_VXSAT) csr_rdata = {29'b0, vxrm_reg, new_val[0]};
                    if (csr_waddr == `CSR_VXRM)  csr_rdata = {29'b0, new_val[1:0], vxsat_reg};
                end
                `CSR_VXSAT: if (csr_waddr == `CSR_VCSR) csr_rdata = {31'b0, new_val[0]};
                `CSR_VXRM : if (csr_waddr == `CSR_VCSR) csr_rdata = {30'b0, new_val[2:1]};
                `CSR_MSTATUS:
                    if ((csr_waddr == `CSR_VSTART) || (csr_waddr == `CSR_VXSAT) ||
                        (csr_waddr == `CSR_VXRM)   || (csr_waddr == `CSR_VCSR))
                        csr_rdata = mstatus_val | 32'h8000_0000 |
                                    (32'h3 << `MSTATUS_VS_LO_BIT);
                default: ;
            endcase
        end
        if ((EN_RVV != 0) && vcfg_we && (csr_raddr == `CSR_MSTATUS))
            csr_rdata = mstatus_val | 32'h8000_0000 | (32'h3 << `MSTATUS_VS_LO_BIT);
        // ADR-0050: same-cycle WB write forwarding for the fflags/frm/fcsr alias
        if ((EN_F != 0) && csr_we) begin
            if (csr_waddr == `CSR_FFLAGS) begin
                if (csr_raddr == `CSR_FCSR) csr_rdata = {24'b0, frm_reg, new_val[4:0]};
            end
            if (csr_waddr == `CSR_FRM) begin
                if (csr_raddr == `CSR_FCSR) csr_rdata = {24'b0, new_val[2:0], fflags_reg};
            end
            if (csr_waddr == `CSR_FCSR) begin
                if (csr_raddr == `CSR_FFLAGS) csr_rdata = {27'b0, new_val[4:0]};
                if (csr_raddr == `CSR_FRM)    csr_rdata = {29'b0, new_val[7:5]};
            end
        end
        // ADR-0050: same-cycle F-op commit (fflags accrual + FS dirty)
        if ((EN_F != 0) && fexec_we) begin
            if (csr_raddr == `CSR_FFLAGS) csr_rdata = csr_rdata | {27'b0, fflags_set};
            if (csr_raddr == `CSR_FCSR)   csr_rdata = csr_rdata | {27'b0, fflags_set};
            if (csr_raddr == `CSR_MSTATUS)
                csr_rdata = csr_rdata | 32'h8000_0000 | (32'h3 << `MSTATUS_FS_LO_BIT);
        end
        // 3B: same-cycle WB commit of a vector-execute op (vstart clear + VS dirty)
        if ((EN_RVV != 0) && vexec_we) begin
            if (csr_raddr == `CSR_VSTART) csr_rdata = 32'h0;
            if (csr_raddr == `CSR_MSTATUS)
                csr_rdata = mstatus_val | 32'h8000_0000 | (32'h3 << `MSTATUS_VS_LO_BIT);
        end
    end

    // -------------------------------------------------------------------------
    // 3. Compute "next value" for whichever CSR is being written this cycle
    //    (CSRRW/RS/RC 對任何 CSR 行為一致，只是 set/clear/swap 差異)
    // -------------------------------------------------------------------------
    always @* begin
        case (csr_op)
            `CSR_OP_W : new_val = csr_wdata;
            `CSR_OP_S : new_val = csr_old_val | csr_wdata;
            `CSR_OP_C : new_val = csr_old_val & ~csr_wdata;
            default   : new_val = csr_old_val;
        endcase
    end

    assign trigger_csr_we      = csr_we && is_trigger_csr(csr_waddr);
    assign trigger_csr_waddr   = csr_waddr;
    assign trigger_csr_wdata   = new_val;
    assign trigger_debug_csr_we    = debug_csr_we && is_trigger_csr(debug_csr_waddr);
    assign trigger_debug_csr_waddr = debug_csr_waddr;
    assign trigger_debug_csr_wdata = debug_csr_wdata;

    // -------------------------------------------------------------------------
    // 4. Sync write logic (CSR* 指令、trap 進入/退出、counter increment)
    // -------------------------------------------------------------------------
    always @(posedge clk) begin
        if (!resetn) begin
            mie_meie     <= 1'b0;
            mie_mtie     <= 1'b0;          // ADR-0019
            mie_msie     <= 1'b0;          // ADR-0019
            mstatus_mie  <= 1'b0;          // 重置時 IRQ 關閉，要靠軟體開
            mstatus_mpie <= 1'b0;
            mstatus_vs   <= 2'b00;
            mtvec_base   <= 30'b0;
            mscratch     <= 32'b0;
            mepc_reg     <= 32'b0;
            mcause_reg   <= 32'b0;
            mtval_reg    <= 32'b0;
            ext_pending  <= 1'b0;
            dpc_reg      <= 32'b0;
            dscratch0_reg <= 32'b0;
            dcsr_step_reg <= 1'b0;
            dcsr_ebreakm_reg <= 1'b0;
            dcsr_cause_reg <= 3'b0;
            vstart_reg   <= 7'h00;
            vxsat_reg    <= 1'b0;
            fflags_reg   <= 5'b0;
            frm_reg      <= 3'b0;
            mstatus_fs   <= 2'b00;
            vxrm_reg     <= 2'b00;
            vl_reg       <= 32'h0;
            vtype_reg    <= 32'h8000_0000;
            cycle_cnt    <= 64'b0;
            instret_cnt  <= 64'b0;
            for (pmp_i = 0; pmp_i < 8; pmp_i = pmp_i + 1) begin
                pmpcfg_r[pmp_i]  <= 8'h00;
                pmpaddr_r[pmp_i] <= 32'h0;
            end
        end else begin
            // S2 (ADR-0049): saturation from a committed vector op (sticky).
            // Cannot collide with a csr write in the same cycle (single WB).
            if ((EN_RVV != 0) && vxsat_set) vxsat_reg <= 1'b1;
            // 4.1 cycle 永遠 +1 (CSR write 不影響)
            cycle_cnt <= cycle_cnt + 1'b1;

            // 4.2 instret 在每條完成 +1
            if (instr_retired)
                instret_cnt <= instret_cnt + 1'b1;

            // 4.3 軟體 CSR 寫入 (CSR* 指令)
            //     只 patch 對應位址的 register；RO 位址寫入忽略
            if (csr_we) begin
                case (csr_waddr)
                    `CSR_MSTATUS : begin
                        mstatus_mie  <= new_val[`MSTATUS_MIE_BIT];
                        mstatus_mpie <= new_val[`MSTATUS_MPIE_BIT];
                        if (EN_RVV != 0)
                            mstatus_vs <= new_val[`MSTATUS_VS_HI_BIT:`MSTATUS_VS_LO_BIT];
                        if (EN_F != 0)
                            mstatus_fs <= new_val[`MSTATUS_FS_HI_BIT:`MSTATUS_FS_LO_BIT];
                        // mstatus.MPP is read-only WARL=M (M-only hart, ADR-0015): write ignored
                    end
                    `CSR_MIE     : begin
                        mie_meie <= new_val[`MIE_MEIE_BIT];
                        mie_mtie <= new_val[`MIE_MTIE_BIT];   // ADR-0019
                        mie_msie <= new_val[`MIE_MSIE_BIT];   // ADR-0019
                    end
                    `CSR_MTVEC   : mtvec_base  <= new_val[31:2];
                    `CSR_MSCRATCH: mscratch    <= new_val;
                    `CSR_MEPC    : mepc_reg    <= {new_val[31:1], 1'b0};
                    `CSR_MCAUSE  : mcause_reg  <= new_val;
                    `CSR_MTVAL   : mtval_reg   <= new_val;
                    `CSR_FFLAGS  : if (EN_F != 0) begin
                        fflags_reg <= new_val[4:0];
                        mstatus_fs <= 2'b11;
                    end
                    `CSR_FRM     : if (EN_F != 0) begin
                        frm_reg <= new_val[2:0];
                        mstatus_fs <= 2'b11;
                    end
                    `CSR_FCSR    : if (EN_F != 0) begin
                        frm_reg <= new_val[7:5];
                        fflags_reg <= new_val[4:0];
                        mstatus_fs <= 2'b11;
                    end
                    `CSR_VSTART  : if (EN_RVV != 0) begin
                        vstart_reg <= new_val[6:0];
                        mstatus_vs <= 2'b11;
                    end
                    `CSR_VXSAT   : if (EN_RVV != 0) begin
                        vxsat_reg <= new_val[0];
                        mstatus_vs <= 2'b11;
                    end
                    `CSR_VXRM    : if (EN_RVV != 0) begin
                        vxrm_reg <= new_val[1:0];
                        mstatus_vs <= 2'b11;
                    end
                    `CSR_VCSR    : if (EN_RVV != 0) begin
                        vxrm_reg <= new_val[2:1];
                        vxsat_reg <= new_val[0];
                        mstatus_vs <= 2'b11;
                    end
                    `CSR_DPC     : dpc_reg     <= {new_val[31:1], 1'b0};
                    `CSR_DSCRATCH0: dscratch0_reg <= new_val;
                    `CSR_PMPCFG0: if (PMP_ENTRIES != 0) begin
                        for (pmp_i = 0; pmp_i < 4; pmp_i = pmp_i + 1)
                            if (!pmpcfg_r[pmp_i][7])
                                pmpcfg_r[pmp_i] <= new_val[pmp_i*8 +: 8];
                    end
                    `CSR_PMPCFG1: if (PMP_ENTRIES > 4) begin
                        for (pmp_i = 0; pmp_i < 4; pmp_i = pmp_i + 1)
                            if (!pmpcfg_r[pmp_i + 4][7])
                                pmpcfg_r[pmp_i + 4] <= new_val[pmp_i*8 +: 8];
                    end
                    `CSR_PMPADDR0,
                    `CSR_PMPADDR1,
                    `CSR_PMPADDR2,
                    `CSR_PMPADDR3,
                    `CSR_PMPADDR4,
                    `CSR_PMPADDR5,
                    `CSR_PMPADDR6,
                    `CSR_PMPADDR7: if (is_pmpaddr_csr(csr_waddr) &&
                                       !pmpcfg_r[pmp_index(csr_waddr)][7]) begin
                        pmpaddr_r[pmp_index(csr_waddr)] <= new_val;
                    end
                    `CSR_DCSR    : begin
                        dcsr_ebreakm_reg <= new_val[15];
                        dcsr_cause_reg   <= new_val[8:6];
                        dcsr_step_reg    <= new_val[2];
                    end
                    // 其他 (MIP / counters / unknown) 忽略
                    // verilator coverage_off
                    default      : ;
                    // verilator coverage_on
                    // ^ CS-COV-1 exclusion: writes to unlisted/RO CSR addrs are ignored by the DUT but trap on the reference model — unreachable for legal traffic
                endcase
            end

            if (debug_csr_we) begin
                case (debug_csr_waddr)
                    `CSR_MSTATUS : begin
                        mstatus_mie  <= debug_csr_wdata[`MSTATUS_MIE_BIT];
                        mstatus_mpie <= debug_csr_wdata[`MSTATUS_MPIE_BIT];
                        if (EN_RVV != 0)
                            mstatus_vs <= debug_csr_wdata[`MSTATUS_VS_HI_BIT:`MSTATUS_VS_LO_BIT];
                    end
                    `CSR_MIE     : begin
                        mie_meie <= debug_csr_wdata[`MIE_MEIE_BIT];
                        mie_mtie <= debug_csr_wdata[`MIE_MTIE_BIT];
                        mie_msie <= debug_csr_wdata[`MIE_MSIE_BIT];
                    end
                    `CSR_MTVEC   : mtvec_base  <= debug_csr_wdata[31:2];
                    `CSR_MSCRATCH: mscratch    <= debug_csr_wdata;
                    `CSR_MEPC    : mepc_reg    <= {debug_csr_wdata[31:1], 1'b0};
                    `CSR_MCAUSE  : mcause_reg  <= debug_csr_wdata;
                    `CSR_MTVAL   : mtval_reg   <= debug_csr_wdata;
                    `CSR_VSTART  : if (EN_RVV != 0) vstart_reg <= debug_csr_wdata[6:0];
                    `CSR_VXSAT   : if (EN_RVV != 0) vxsat_reg <= debug_csr_wdata[0];
                    `CSR_VXRM    : if (EN_RVV != 0) vxrm_reg <= debug_csr_wdata[1:0];
                    `CSR_VCSR    : if (EN_RVV != 0) begin
                        vxrm_reg <= debug_csr_wdata[2:1];
                        vxsat_reg <= debug_csr_wdata[0];
                    end
                    `CSR_VL      : if (EN_RVV != 0) vl_reg <= debug_csr_wdata;
                    `CSR_VTYPE   : if (EN_RVV != 0) vtype_reg <= debug_csr_wdata;
                    `CSR_DPC     : dpc_reg     <= {debug_csr_wdata[31:1], 1'b0};
                    `CSR_DSCRATCH0: dscratch0_reg <= debug_csr_wdata;
                    `CSR_PMPCFG0: if (PMP_ENTRIES != 0) begin
                        for (pmp_i = 0; pmp_i < 4; pmp_i = pmp_i + 1)
                            if (!pmpcfg_r[pmp_i][7])
                                pmpcfg_r[pmp_i] <= debug_csr_wdata[pmp_i*8 +: 8];
                    end
                    `CSR_PMPCFG1: if (PMP_ENTRIES > 4) begin
                        for (pmp_i = 0; pmp_i < 4; pmp_i = pmp_i + 1)
                            if (!pmpcfg_r[pmp_i + 4][7])
                                pmpcfg_r[pmp_i + 4] <= debug_csr_wdata[pmp_i*8 +: 8];
                    end
                    `CSR_PMPADDR0,
                    `CSR_PMPADDR1,
                    `CSR_PMPADDR2,
                    `CSR_PMPADDR3,
                    `CSR_PMPADDR4,
                    `CSR_PMPADDR5,
                    `CSR_PMPADDR6,
                    `CSR_PMPADDR7: if (is_pmpaddr_csr(debug_csr_waddr) &&
                                       !pmpcfg_r[pmp_index(debug_csr_waddr)][7]) begin
                        pmpaddr_r[pmp_index(debug_csr_waddr)] <= debug_csr_wdata;
                    end
                    `CSR_DCSR    : begin
                        dcsr_ebreakm_reg <= debug_csr_wdata[15];
                        dcsr_cause_reg   <= debug_csr_wdata[8:6];
                        dcsr_step_reg    <= debug_csr_wdata[2];
                    end
                    default: ;
                endcase
            end

            if ((EN_RVV != 0) && vcfg_we) begin
                vl_reg     <= vcfg_vl;
                vtype_reg  <= vcfg_vtype;
                vstart_reg <= 7'h00;
                mstatus_vs <= 2'b11;
            end
            if ((EN_RVV != 0) && vexec_we) begin
                vstart_reg <= 7'h00;
                mstatus_vs <= 2'b11;
            end

            // ADR-0050: F-op commit — sticky fflags accrual + FS dirty
            if ((EN_F != 0) && fexec_we) begin
                fflags_reg <= fflags_reg | fflags_set;
                mstatus_fs <= 2'b11;
            end

            // 4.4 硬體 trap entry / exit
            //     core.v 保證 trap_enter / trap_exit / csr_we 三者互斥；
            //     不過 trap_enter 在源碼順序上放在 csr_we 後面，
            //     就算同 cycle 都 fire 也是 trap_enter 路徑的 NBA 寫贏。
            if (trap_enter) begin
                mepc_reg     <= trap_pc;
                mcause_reg   <= trap_cause;
                mtval_reg    <= trap_mtval;
                mstatus_mpie <= mstatus_mie;
                mstatus_mie  <= 1'b0;
            end else if (trap_exit) begin
                mstatus_mie  <= mstatus_mpie;
                mstatus_mpie <= 1'b1;            // spec: MPIE <- 1 after mret
            end

            if (debug_halt_enter) begin
                dpc_reg         <= {debug_halt_pc[31:1], 1'b0};
                dcsr_cause_reg  <= debug_halt_cause;
            end

            // 4.5 ext_pending 三優先級邏輯 (trap_enter > pulse > hold)
            //     - trap_enter → clear (hardware ack)
            //     - 新 pulse 進來且沒有同拍 trap_enter → set
            //     - 其他保持
            //     寫成一條 mux 而不是兩個 if，邏輯 + timing 都比較乾淨
            ext_pending <=
                trap_enter         ? 1'b0 :
                irq_external_pulse ? 1'b1 :
                                     ext_pending;
        end
    end

    // -------------------------------------------------------------------------
    // 5. 輸出
    // -------------------------------------------------------------------------
    assign mtvec_o     = mtvec_val;
    assign mepc_o      = mepc_reg;
    assign dpc_o       = dpc_reg;
    assign dcsr_step_o = dcsr_step_reg;
    assign dcsr_ebreakm_o = dcsr_ebreakm_reg;
    assign debug_csr_rdata = csr_debug_read(debug_csr_waddr);
    assign mstatus_vs_o = mstatus_vs_visible;
    assign mstatus_fs_o = mstatus_fs_visible;
    assign vl_o         = (EN_RVV != 0) ? vl_reg : 32'h0;
    assign vxrm_o       = (EN_RVV != 0) ? vxrm_reg : 2'b00;
    assign vtype_o      = (EN_RVV != 0) ? vtype_reg : 32'h8000_0000;
    assign vstart_o     = (EN_RVV != 0) ? {25'b0, vstart_reg} : 32'h0;
    genvar pmp_g;
    generate
        for (pmp_g = 0; pmp_g < 8; pmp_g = pmp_g + 1) begin : g_pmp_flatten
            assign pmp_cfg_o[pmp_g*8 +: 8] = ((PMP_ENTRIES != 0) && (pmp_g < PMP_ENTRIES)) ?
                                             pmpcfg_r[pmp_g] : 8'h00;
            assign pmp_addr_o[pmp_g*32 +: 32] = ((PMP_ENTRIES != 0) && (pmp_g < PMP_ENTRIES)) ?
                                                pmpaddr_r[pmp_g] : 32'h0;
        end
    endgenerate

    // Interrupt arbitration (ADR-0019). mip[3,7,11] are CLINT/ext-sourced (RO to CSR
    // writes); only mie + mstatus.MIE gate delivery. Priority MEI > MSI > MTI (priv spec).
    wire irq_mei = (ext_pending | meip) & mie_meie;  // M external: legacy pulse-sticky OR PLIC level (ADR-0020)
    wire irq_msi = msip        & mie_msie;   // M software
    wire irq_mti = mtip        & mie_mtie;   // M timer (lowest)
    assign irq_pending = (irq_mei | irq_msi | irq_mti) & mstatus_mie;
    assign irq_cause   = irq_mei ? `MCAUSE_EXT_IRQ   :
                         irq_msi ? `MCAUSE_MSW_IRQ   :
                                   `MCAUSE_TIMER_IRQ;

endmodule
