Hans-Wis/Magpie_M3V/design/soc/soc_axil_decode.v

// =============================================================================
// soc_axil_decode.v — M3V minimal host data AXI4-Lite decoder
// -----------------------------------------------------------------------------
// 0x300?_???? -> npu_top AXI4-Lite slave (CSR/DTCM/ITCM window)
// 0x0c??_???? -> PLIC AXI4-Lite shim
// 0x1000_???? -> UART AXI4-Lite shim
// 0x0200_???? -> CLINT AXI4-Lite shim
// 0x40??_???? -> QSPI XIP AXI4-Lite front-end
// 0x410?_???? -> QSPI CSR AXI4-Lite shim
// 0x8000_???? -> shared SRAM host leg
// 0x1100_???? -> GPIO AXI4-Lite shim
// otherwise    -> DECERR/SLVERR response with no hang
// =============================================================================
`default_nettype none

module soc_axil_decode (
    input  wire        clk,
    input  wire        resetn,

    input  wire        s_awvalid,
    output wire        s_awready,
    input  wire [31:0] s_awaddr,
    input  wire [ 2:0] s_awprot,
    input  wire        s_wvalid,
    output wire        s_wready,
    input  wire [31:0] s_wdata,
    input  wire [ 3:0] s_wstrb,
    output wire        s_bvalid,
    input  wire        s_bready,
    output wire [ 1:0] s_bresp,
    input  wire        s_arvalid,
    output wire        s_arready,
    input  wire [31:0] s_araddr,
    input  wire [ 2:0] s_arprot,
    output wire        s_rvalid,
    input  wire        s_rready,
    output wire [31:0] s_rdata,
    output wire [ 1:0] s_rresp,

    output wire        n_awvalid,
    input  wire        n_awready,
    output wire [31:0] n_awaddr,
    output wire [ 2:0] n_awprot,
    output wire        n_wvalid,
    input  wire        n_wready,
    output wire [31:0] n_wdata,
    output wire [ 3:0] n_wstrb,
    input  wire        n_bvalid,
    output wire        n_bready,
    input  wire [ 1:0] n_bresp,
    output wire        n_arvalid,
    input  wire        n_arready,
    output wire [31:0] n_araddr,
    output wire [ 2:0] n_arprot,
    input  wire        n_rvalid,
    output wire        n_rready,
    input  wire [31:0] n_rdata,
    input  wire [ 1:0] n_rresp,

    output wire        p_awvalid,
    input  wire        p_awready,
    output wire [31:0] p_awaddr,
    output wire [ 2:0] p_awprot,
    output wire        p_wvalid,
    input  wire        p_wready,
    output wire [31:0] p_wdata,
    output wire [ 3:0] p_wstrb,
    input  wire        p_bvalid,
    output wire        p_bready,
    input  wire [ 1:0] p_bresp,
    output wire        p_arvalid,
    input  wire        p_arready,
    output wire [31:0] p_araddr,
    output wire [ 2:0] p_arprot,
    input  wire        p_rvalid,
    output wire        p_rready,
    input  wire [31:0] p_rdata,
    input  wire [ 1:0] p_rresp,

    output wire        u_awvalid,
    input  wire        u_awready,
    output wire [31:0] u_awaddr,
    output wire [ 2:0] u_awprot,
    output wire        u_wvalid,
    input  wire        u_wready,
    output wire [31:0] u_wdata,
    output wire [ 3:0] u_wstrb,
    input  wire        u_bvalid,
    output wire        u_bready,
    input  wire [ 1:0] u_bresp,
    output wire        u_arvalid,
    input  wire        u_arready,
    output wire [31:0] u_araddr,
    output wire [ 2:0] u_arprot,
    input  wire        u_rvalid,
    output wire        u_rready,
    input  wire [31:0] u_rdata,
    input  wire [ 1:0] u_rresp,

    output wire        c_awvalid,
    input  wire        c_awready,
    output wire [31:0] c_awaddr,
    output wire [ 2:0] c_awprot,
    output wire        c_wvalid,
    input  wire        c_wready,
    output wire [31:0] c_wdata,
    output wire [ 3:0] c_wstrb,
    input  wire        c_bvalid,
    output wire        c_bready,
    input  wire [ 1:0] c_bresp,
    output wire        c_arvalid,
    input  wire        c_arready,
    output wire [31:0] c_araddr,
    output wire [ 2:0] c_arprot,
    input  wire        c_rvalid,
    output wire        c_rready,
    input  wire [31:0] c_rdata,
    input  wire [ 1:0] c_rresp,

    output wire        g_awvalid,
    input  wire        g_awready,
    output wire [31:0] g_awaddr,
    output wire [ 2:0] g_awprot,
    output wire        g_wvalid,
    input  wire        g_wready,
    output wire [31:0] g_wdata,
    output wire [ 3:0] g_wstrb,
    input  wire        g_bvalid,
    output wire        g_bready,
    input  wire [ 1:0] g_bresp,
    output wire        g_arvalid,
    input  wire        g_arready,
    output wire [31:0] g_araddr,
    output wire [ 2:0] g_arprot,
    input  wire        g_rvalid,
    output wire        g_rready,
    input  wire [31:0] g_rdata,
    input  wire [ 1:0] g_rresp,

    output wire        x_awvalid,
    input  wire        x_awready,
    output wire [31:0] x_awaddr,
    output wire [ 2:0] x_awprot,
    output wire        x_wvalid,
    input  wire        x_wready,
    output wire [31:0] x_wdata,
    output wire [ 3:0] x_wstrb,
    input  wire        x_bvalid,
    output wire        x_bready,
    input  wire [ 1:0] x_bresp,
    output wire        x_arvalid,
    input  wire        x_arready,
    output wire [31:0] x_araddr,
    output wire [ 2:0] x_arprot,
    input  wire        x_rvalid,
    output wire        x_rready,
    input  wire [31:0] x_rdata,
    input  wire [ 1:0] x_rresp,

    output wire        q_awvalid,
    input  wire        q_awready,
    output wire [31:0] q_awaddr,
    output wire [ 2:0] q_awprot,
    output wire        q_wvalid,
    input  wire        q_wready,
    output wire [31:0] q_wdata,
    output wire [ 3:0] q_wstrb,
    input  wire        q_bvalid,
    output wire        q_bready,
    input  wire [ 1:0] q_bresp,
    output wire        q_arvalid,
    input  wire        q_arready,
    output wire [31:0] q_araddr,
    output wire [ 2:0] q_arprot,
    input  wire        q_rvalid,
    output wire        q_rready,
    input  wire [31:0] q_rdata,
    input  wire [ 1:0] q_rresp,

    output wire        m_awvalid,
    input  wire        m_awready,
    output wire [31:0] m_awaddr,
    output wire [ 2:0] m_awprot,
    output wire        m_wvalid,
    input  wire        m_wready,
    output wire [31:0] m_wdata,
    output wire [ 3:0] m_wstrb,
    input  wire        m_bvalid,
    output wire        m_bready,
    input  wire [ 1:0] m_bresp,
    output wire        m_arvalid,
    input  wire        m_arready,
    output wire [31:0] m_araddr,
    output wire [ 2:0] m_arprot,
    input  wire        m_rvalid,
    output wire        m_rready,
    input  wire [31:0] m_rdata,
    input  wire [ 1:0] m_rresp
);
    localparam [3:0] ROUTE_NPU      = 4'd0;
    localparam [3:0] ROUTE_MEM      = 4'd1;
    localparam [3:0] ROUTE_PLIC     = 4'd2;
    localparam [3:0] ROUTE_UART     = 4'd3;
    localparam [3:0] ROUTE_CLINT    = 4'd4;
    localparam [3:0] ROUTE_XIP      = 4'd5;
    localparam [3:0] ROUTE_GPIO     = 4'd6;
    localparam [3:0] ROUTE_QSPI_CSR = 4'd8;
    localparam [3:0] ROUTE_ERR      = 4'd15;

    function [3:0] dec;
        input [31:0] a;
        begin
            if (a[31:20] == 12'h300)       dec = ROUTE_NPU;
            else if (a[31:24] == 8'h0c)    dec = ROUTE_PLIC;
            else if (a[31:16] == 16'h1000) dec = ROUTE_UART;
            else if (a[31:16] == 16'h0200) dec = ROUTE_CLINT;
            else if (a[31:20] == 12'h410)  dec = ROUTE_QSPI_CSR;
            else if (a[31:24] == 8'h40)    dec = ROUTE_XIP;
            else if (a[31:16] == 16'h8000) dec = ROUTE_MEM;
            else if (a[31:16] == 16'h1100) dec = ROUTE_GPIO;
            else                           dec = ROUTE_ERR;
        end
    endfunction

    reg        w_busy, r_busy;
    reg [3:0]  w_route_q, r_route_q;
    reg        err_bvalid, err_rvalid;
    wire [3:0] w_route = w_busy ? w_route_q : dec(s_awaddr);
    wire [3:0] r_route = r_busy ? r_route_q : dec(s_araddr);
    wire       w_known = w_busy | s_awvalid;

    assign n_awvalid = s_awvalid && (w_route == ROUTE_NPU);
    assign p_awvalid = s_awvalid && (w_route == ROUTE_PLIC);
    assign u_awvalid = s_awvalid && (w_route == ROUTE_UART);
    assign c_awvalid = s_awvalid && (w_route == ROUTE_CLINT);
    assign g_awvalid = s_awvalid && (w_route == ROUTE_GPIO);
    assign x_awvalid = s_awvalid && (w_route == ROUTE_XIP);
    assign q_awvalid = s_awvalid && (w_route == ROUTE_QSPI_CSR);
    assign m_awvalid = s_awvalid && (w_route == ROUTE_MEM);
    assign n_awaddr = s_awaddr;
    assign p_awaddr = s_awaddr;
    assign u_awaddr = s_awaddr;
    assign c_awaddr = s_awaddr;
    assign g_awaddr = s_awaddr;
    assign x_awaddr = s_awaddr;
    assign q_awaddr = s_awaddr;
    assign m_awaddr = s_awaddr;
    assign n_awprot = s_awprot;
    assign p_awprot = s_awprot;
    assign u_awprot = s_awprot;
    assign c_awprot = s_awprot;
    assign g_awprot = s_awprot;
    assign x_awprot = s_awprot;
    assign q_awprot = s_awprot;
    assign m_awprot = s_awprot;

    assign n_wvalid = s_wvalid && w_known && (w_route == ROUTE_NPU);
    assign p_wvalid = s_wvalid && w_known && (w_route == ROUTE_PLIC);
    assign u_wvalid = s_wvalid && w_known && (w_route == ROUTE_UART);
    assign c_wvalid = s_wvalid && w_known && (w_route == ROUTE_CLINT);
    assign g_wvalid = s_wvalid && w_known && (w_route == ROUTE_GPIO);
    assign x_wvalid = s_wvalid && w_known && (w_route == ROUTE_XIP);
    assign q_wvalid = s_wvalid && w_known && (w_route == ROUTE_QSPI_CSR);
    assign m_wvalid = s_wvalid && w_known && (w_route == ROUTE_MEM);
    assign n_wdata = s_wdata;
    assign p_wdata = s_wdata;
    assign u_wdata = s_wdata;
    assign c_wdata = s_wdata;
    assign g_wdata = s_wdata;
    assign x_wdata = s_wdata;
    assign q_wdata = s_wdata;
    assign m_wdata = s_wdata;
    assign n_wstrb = s_wstrb;
    assign p_wstrb = s_wstrb;
    assign u_wstrb = s_wstrb;
    assign c_wstrb = s_wstrb;
    assign g_wstrb = s_wstrb;
    assign x_wstrb = s_wstrb;
    assign q_wstrb = s_wstrb;
    assign m_wstrb = s_wstrb;

    assign n_bready = s_bready && (w_route == ROUTE_NPU);
    assign p_bready = s_bready && (w_route == ROUTE_PLIC);
    assign u_bready = s_bready && (w_route == ROUTE_UART);
    assign c_bready = s_bready && (w_route == ROUTE_CLINT);
    assign g_bready = s_bready && (w_route == ROUTE_GPIO);
    assign x_bready = s_bready && (w_route == ROUTE_XIP);
    assign q_bready = s_bready && (w_route == ROUTE_QSPI_CSR);
    assign m_bready = s_bready && (w_route == ROUTE_MEM);

    assign s_awready = (w_route == ROUTE_NPU) ? n_awready :
                       (w_route == ROUTE_PLIC) ? p_awready :
                       (w_route == ROUTE_UART) ? u_awready :
                       (w_route == ROUTE_CLINT) ? c_awready :
                       (w_route == ROUTE_GPIO) ? g_awready :
                       (w_route == ROUTE_XIP) ? x_awready :
                       (w_route == ROUTE_QSPI_CSR) ? q_awready :
                       (w_route == ROUTE_MEM) ? m_awready :
                       (!w_busy && !err_bvalid);
    assign s_wready  = !w_known ? 1'b0 :
                       (w_route == ROUTE_NPU) ? n_wready :
                       (w_route == ROUTE_PLIC) ? p_wready :
                       (w_route == ROUTE_UART) ? u_wready :
                       (w_route == ROUTE_CLINT) ? c_wready :
                       (w_route == ROUTE_GPIO) ? g_wready :
                       (w_route == ROUTE_XIP) ? x_wready :
                       (w_route == ROUTE_QSPI_CSR) ? q_wready :
                       (w_route == ROUTE_MEM) ? m_wready :
                       (!err_bvalid);
    assign s_bvalid  = (w_route == ROUTE_NPU) ? n_bvalid :
                       (w_route == ROUTE_PLIC) ? p_bvalid :
                       (w_route == ROUTE_UART) ? u_bvalid :
                       (w_route == ROUTE_CLINT) ? c_bvalid :
                       (w_route == ROUTE_GPIO) ? g_bvalid :
                       (w_route == ROUTE_XIP) ? x_bvalid :
                       (w_route == ROUTE_QSPI_CSR) ? q_bvalid :
                       (w_route == ROUTE_MEM) ? m_bvalid :
                       err_bvalid;
    assign s_bresp   = (w_route == ROUTE_NPU) ? n_bresp :
                       (w_route == ROUTE_PLIC) ? p_bresp :
                       (w_route == ROUTE_UART) ? u_bresp :
                       (w_route == ROUTE_CLINT) ? c_bresp :
                       (w_route == ROUTE_GPIO) ? g_bresp :
                       (w_route == ROUTE_XIP) ? x_bresp :
                       (w_route == ROUTE_QSPI_CSR) ? q_bresp :
                       (w_route == ROUTE_MEM) ? m_bresp :
                       2'b10;

    assign n_arvalid = s_arvalid && (r_route == ROUTE_NPU);
    assign p_arvalid = s_arvalid && (r_route == ROUTE_PLIC);
    assign u_arvalid = s_arvalid && (r_route == ROUTE_UART);
    assign c_arvalid = s_arvalid && (r_route == ROUTE_CLINT);
    assign g_arvalid = s_arvalid && (r_route == ROUTE_GPIO);
    assign x_arvalid = s_arvalid && (r_route == ROUTE_XIP);
    assign q_arvalid = s_arvalid && (r_route == ROUTE_QSPI_CSR);
    assign m_arvalid = s_arvalid && (r_route == ROUTE_MEM);
    assign n_araddr = s_araddr;
    assign p_araddr = s_araddr;
    assign u_araddr = s_araddr;
    assign c_araddr = s_araddr;
    assign g_araddr = s_araddr;
    assign x_araddr = s_araddr;
    assign q_araddr = s_araddr;
    assign m_araddr = s_araddr;
    assign n_arprot = s_arprot;
    assign p_arprot = s_arprot;
    assign u_arprot = s_arprot;
    assign c_arprot = s_arprot;
    assign g_arprot = s_arprot;
    assign x_arprot = s_arprot;
    assign q_arprot = s_arprot;
    assign m_arprot = s_arprot;
    assign n_rready = s_rready && (r_route == ROUTE_NPU);
    assign p_rready = s_rready && (r_route == ROUTE_PLIC);
    assign u_rready = s_rready && (r_route == ROUTE_UART);
    assign c_rready = s_rready && (r_route == ROUTE_CLINT);
    assign g_rready = s_rready && (r_route == ROUTE_GPIO);
    assign x_rready = s_rready && (r_route == ROUTE_XIP);
    assign q_rready = s_rready && (r_route == ROUTE_QSPI_CSR);
    assign m_rready = s_rready && (r_route == ROUTE_MEM);

    assign s_arready = (r_route == ROUTE_NPU) ? n_arready :
                       (r_route == ROUTE_PLIC) ? p_arready :
                       (r_route == ROUTE_UART) ? u_arready :
                       (r_route == ROUTE_CLINT) ? c_arready :
                       (r_route == ROUTE_GPIO) ? g_arready :
                       (r_route == ROUTE_XIP) ? x_arready :
                       (r_route == ROUTE_QSPI_CSR) ? q_arready :
                       (r_route == ROUTE_MEM) ? m_arready :
                       (!r_busy && !err_rvalid);
    assign s_rvalid  = (r_route == ROUTE_NPU) ? n_rvalid :
                       (r_route == ROUTE_PLIC) ? p_rvalid :
                       (r_route == ROUTE_UART) ? u_rvalid :
                       (r_route == ROUTE_CLINT) ? c_rvalid :
                       (r_route == ROUTE_GPIO) ? g_rvalid :
                       (r_route == ROUTE_XIP) ? x_rvalid :
                       (r_route == ROUTE_QSPI_CSR) ? q_rvalid :
                       (r_route == ROUTE_MEM) ? m_rvalid :
                       err_rvalid;
    assign s_rdata   = (r_route == ROUTE_NPU) ? n_rdata :
                       (r_route == ROUTE_PLIC) ? p_rdata :
                       (r_route == ROUTE_UART) ? u_rdata :
                       (r_route == ROUTE_CLINT) ? c_rdata :
                       (r_route == ROUTE_GPIO) ? g_rdata :
                       (r_route == ROUTE_XIP) ? x_rdata :
                       (r_route == ROUTE_QSPI_CSR) ? q_rdata :
                       (r_route == ROUTE_MEM) ? m_rdata :
                       32'hDECE_0001;
    assign s_rresp   = (r_route == ROUTE_NPU) ? n_rresp :
                       (r_route == ROUTE_PLIC) ? p_rresp :
                       (r_route == ROUTE_UART) ? u_rresp :
                       (r_route == ROUTE_CLINT) ? c_rresp :
                       (r_route == ROUTE_GPIO) ? g_rresp :
                       (r_route == ROUTE_XIP) ? x_rresp :
                       (r_route == ROUTE_QSPI_CSR) ? q_rresp :
                       (r_route == ROUTE_MEM) ? m_rresp :
                       2'b10;

    always @(posedge clk) begin
        if (!resetn) begin
            w_busy <= 1'b0;
            r_busy <= 1'b0;
            w_route_q <= ROUTE_ERR;
            r_route_q <= ROUTE_ERR;
            err_bvalid <= 1'b0;
            err_rvalid <= 1'b0;
        end else begin
            if (!w_busy && s_awvalid && s_awready) begin
                w_busy <= 1'b1;
                w_route_q <= dec(s_awaddr);
            end
            if (!r_busy && s_arvalid && s_arready) begin
                r_busy <= 1'b1;
                r_route_q <= dec(s_araddr);
                if (dec(s_araddr) == ROUTE_ERR) err_rvalid <= 1'b1;
            end
            if (s_awvalid && s_awready && dec(s_awaddr) == ROUTE_ERR &&
                s_wvalid && s_wready)
                err_bvalid <= 1'b1;
            else if (w_busy && w_route_q == ROUTE_ERR && s_wvalid && s_wready)
                err_bvalid <= 1'b1;

            if (s_bvalid && s_bready) begin
                w_busy <= 1'b0;
                err_bvalid <= 1'b0;
            end
            if (s_rvalid && s_rready) begin
                r_busy <= 1'b0;
                err_rvalid <= 1'b0;
            end
        end
    end
endmodule
`default_nettype wire
