Hans-Wis/Magpie_M3V/design/npu/rtl/npu_tcm.v

// =============================================================================
// npu_tcm.v — Magpie_M3V NPU tightly-coupled memories (ADR-0044)
// -----------------------------------------------------------------------------
// npu_tcm  = DTCM, 32KB (Coral row-4 sizing): data/weights/tensor tiles.
//   Structural model: 8-way word-interleaved banks (bank = word_addr[2:0]),
//   budget 2R + 1W per bank per cycle. The 32B-aligned engine windows
//   (ADR-0040) land exactly one access per bank; a sim-only checker counts
//   every enabled read per bank per cycle and tallies budget violations —
//   e2e gates assert ZERO, gate_52 proves the checker can fire.
// npu_itcm = ITCM, 8KB: instruction fetch + host load window (0x3002_xxxx).
// Harvard contract: the SAME firmware image is loaded into both memories
// (all load-visible bytes — rodata/literals included — exist in DTCM at the
// same offsets, matching Spike's flat view); stores never alter the fetch
// stream (no self-modifying code — the random generator never emits it).
// =============================================================================
`default_nettype none

module npu_tcm #(
    parameter integer WORDS = 1024,       // sim size; real ITCM 8KB + DTCM 32KB
    parameter integer AW    = 10,         // word-address width (log2 WORDS)
    parameter integer DMA_DATA_W = 32,
    parameter integer LANES = 4
) (
    input  wire        clk,
    input  wire        resetn,
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
